nanosatlab/RFI-5G/HW/RFI-5G/RFI-5G_RF_Bottom/RFI-5G_RF_Bottom/RFI-5G_RF_Bottom_OutputJob/RFI-5G_RF_Bottom-User_1.dxf

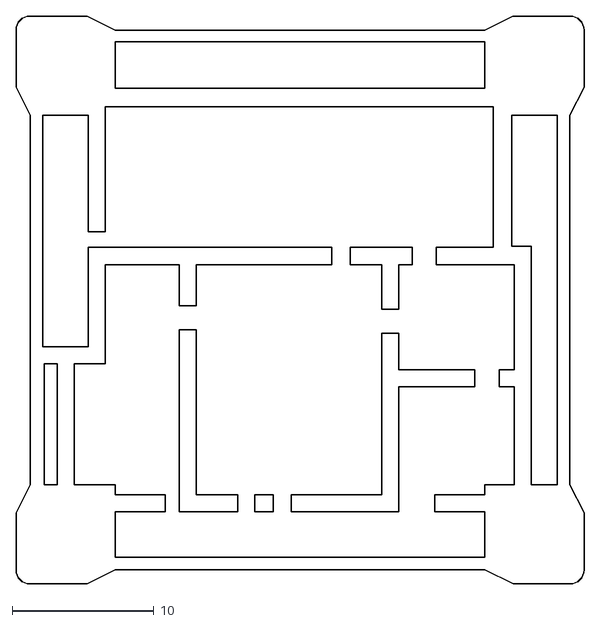
[picture p1: CAD file, 2022-07-15]
HW/RFI-5G/RFI-5G_RF_Bottom/RFI-5G_RF_Bottom/RFI-5G_RF_Bottom_OutputJob/RFI-5G_RF_Bottom-User_1.dxf
40.0 x 40.0
