nanosatlab/RFI-5G/HW/RFI-5G/RFI-5G_RF_Top/RFI-5G_RF_Top_OutputJob/RFI-5G_RF_Top-Edge_Cuts.dxf

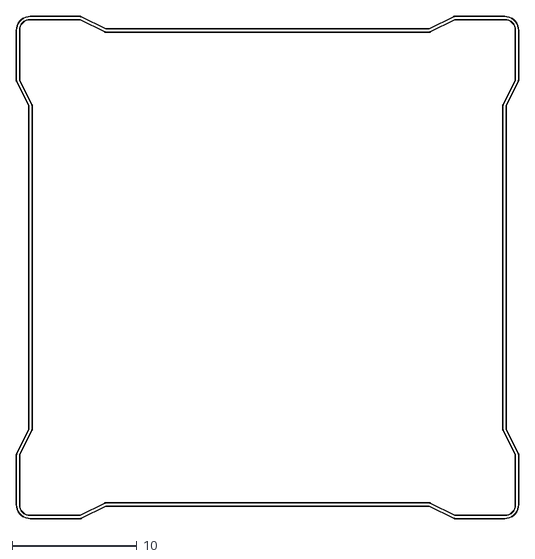
[picture p2: CAD file, 2022-07-15]
HW/RFI-5G/RFI-5G_RF_Top/RFI-5G_RF_Top_OutputJob/RFI-5G_RF_Top-Edge_Cuts.dxf
40.2 x 40.2
