nanosatlab/RFI-5G/HW/RFI-5G/RFI-5G_SupportFR4/RFI-5G_SupportFR4/RFI-5G_SupportFR4.step

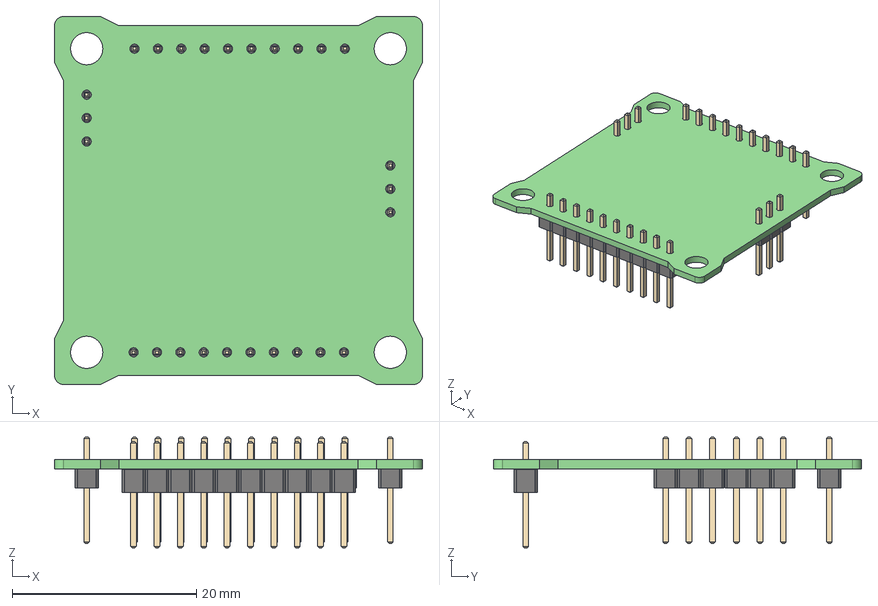
[picture p3: CAD file, 2022-08-02]
HW/RFI-5G/RFI-5G_SupportFR4/RFI-5G_SupportFR4/RFI-5G_SupportFR4.step
40.0 x 40.0 x 12.0 mm
RFI-5G_SupportFR4 PCB
