nanosatlab/RFI-5G/HW/RFI-5G/SMP-FS2A-860.stp

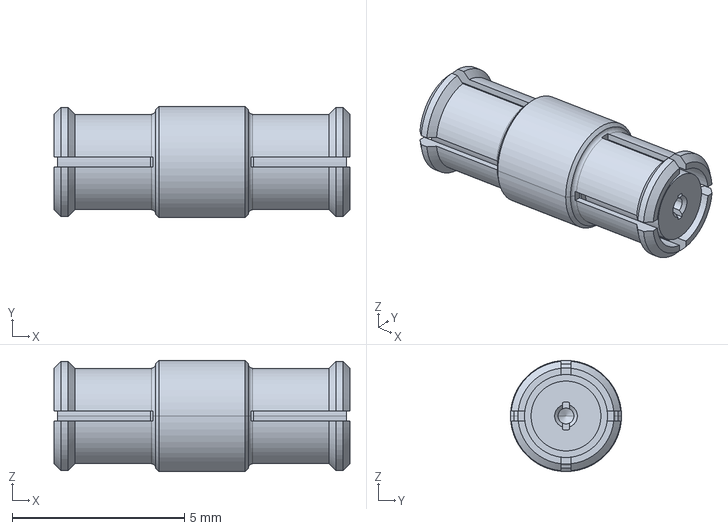
[picture p4: CAD file, 2022-07-15]
HW/RFI-5G/SMP-FS2A-860.stp
8.60 x 3.23 x 3.23 mm
