nanosatlab/RFI-5G/HW/RFI-5G/PCB_Outline_2022-03-01.step

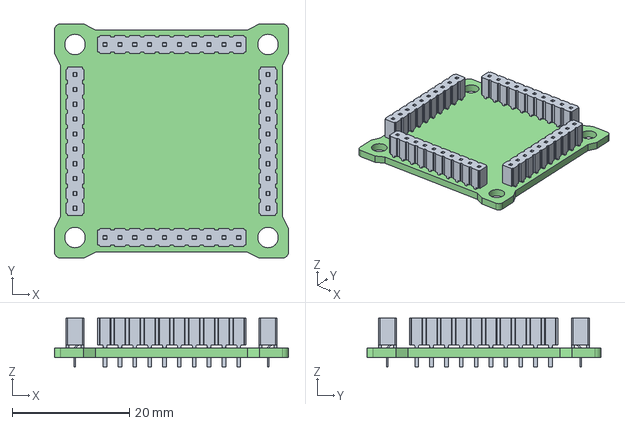
[picture p5: CAD file, 2022-07-15]
HW/RFI-5G/PCB_Outline_2022-03-01.step
40.0 x 40.0 x 8.33 mm
PCB_Outline_2022-03-01 PCB
