nanosatlab/RFI-5G/HW/RFI-5G/RFI-5G_RF_Top/RFI-5G_RF_Top_OutputJob/RFI-5G_RF_Top-User_Eco1.dxf

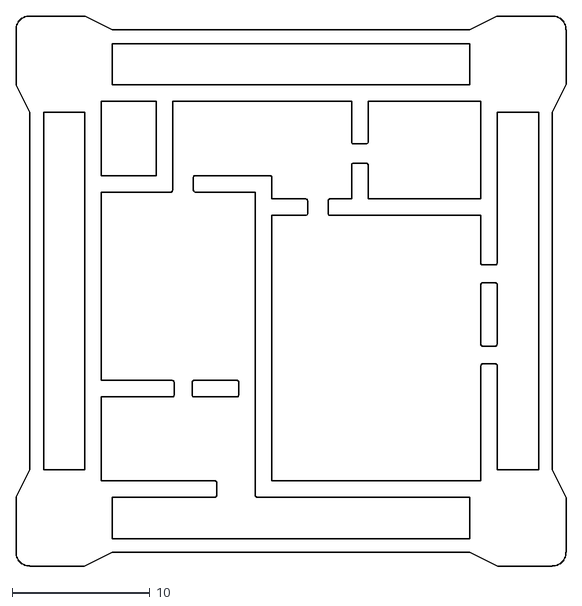
[picture p6: CAD file, 2022-07-15]
HW/RFI-5G/RFI-5G_RF_Top/RFI-5G_RF_Top_OutputJob/RFI-5G_RF_Top-User_Eco1.dxf
40.0 x 40.0
