nanosatlab/RFI-5G/HW/RFI-5G/Support_Top.STEP

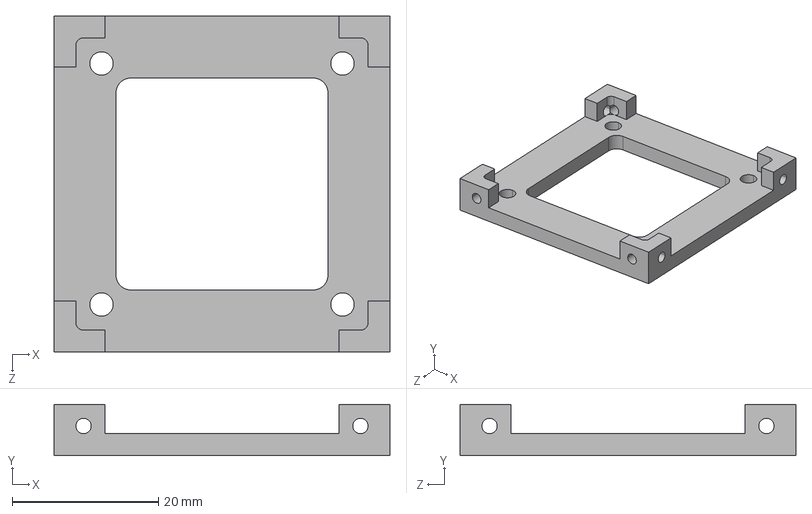
[picture p7: CAD file, 2022-06-21]
HW/RFI-5G/Support_Top.STEP
46.0 x 7.00 x 46.0 mm
