nanosatlab/RFI-5G/(list of files, cad)

Other CAD files:
HW/RFI-5G/RFI-5G_RF_Top/RFI-5G_RF_Top_OutputJob/RFI-5G_RF_Top-B_Mask.dxf
