nanosatlab/RFI-5G/HW/RFI-5G/Prova_Top&Bottom/RFI-5G_RF_Bottom&Top/RFI-5G_RF_Bottom&Top.pdf

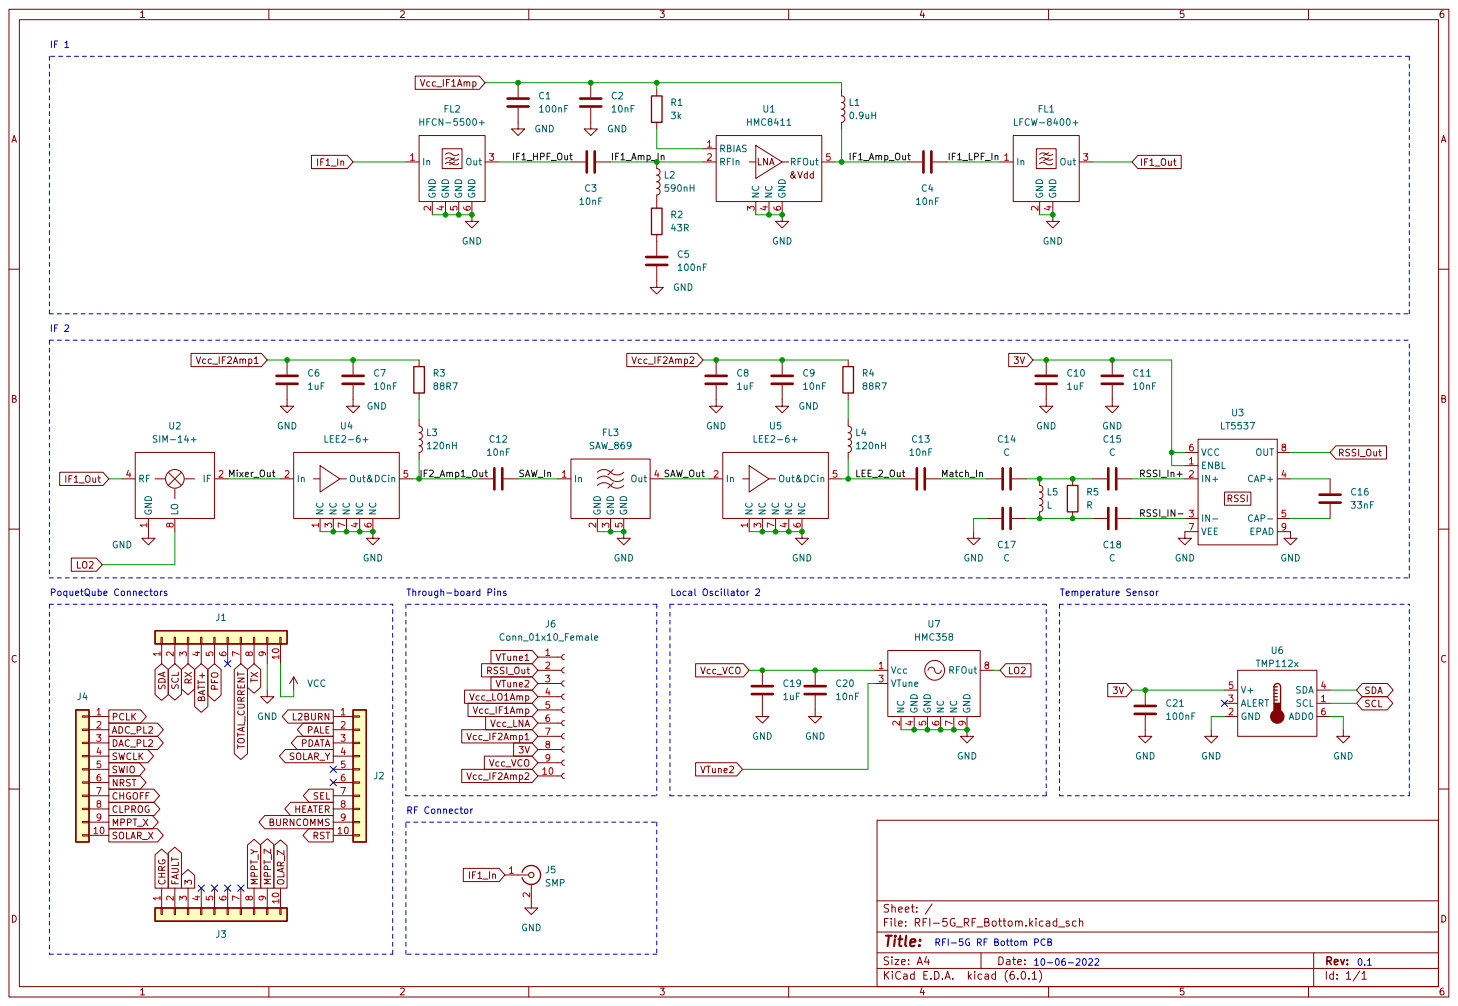
[picture p8: page 1]

10-06-2022 RFI-5G RF Bottom PCB
