nanosatlab/RFI-5G/HW/RFI-5G/RFI-5G_RF_Bottom/RFI-5G_RF_Bottom/RFI-5G_RF_Bottom.kicad_pcb

## KiCad design HW/RFI-5G/RFI-5G_RF_Bottom/RFI-5G_RF_Bottom/RFI-5G_RF_Bottom.kicad_pcb (2022-08-02)

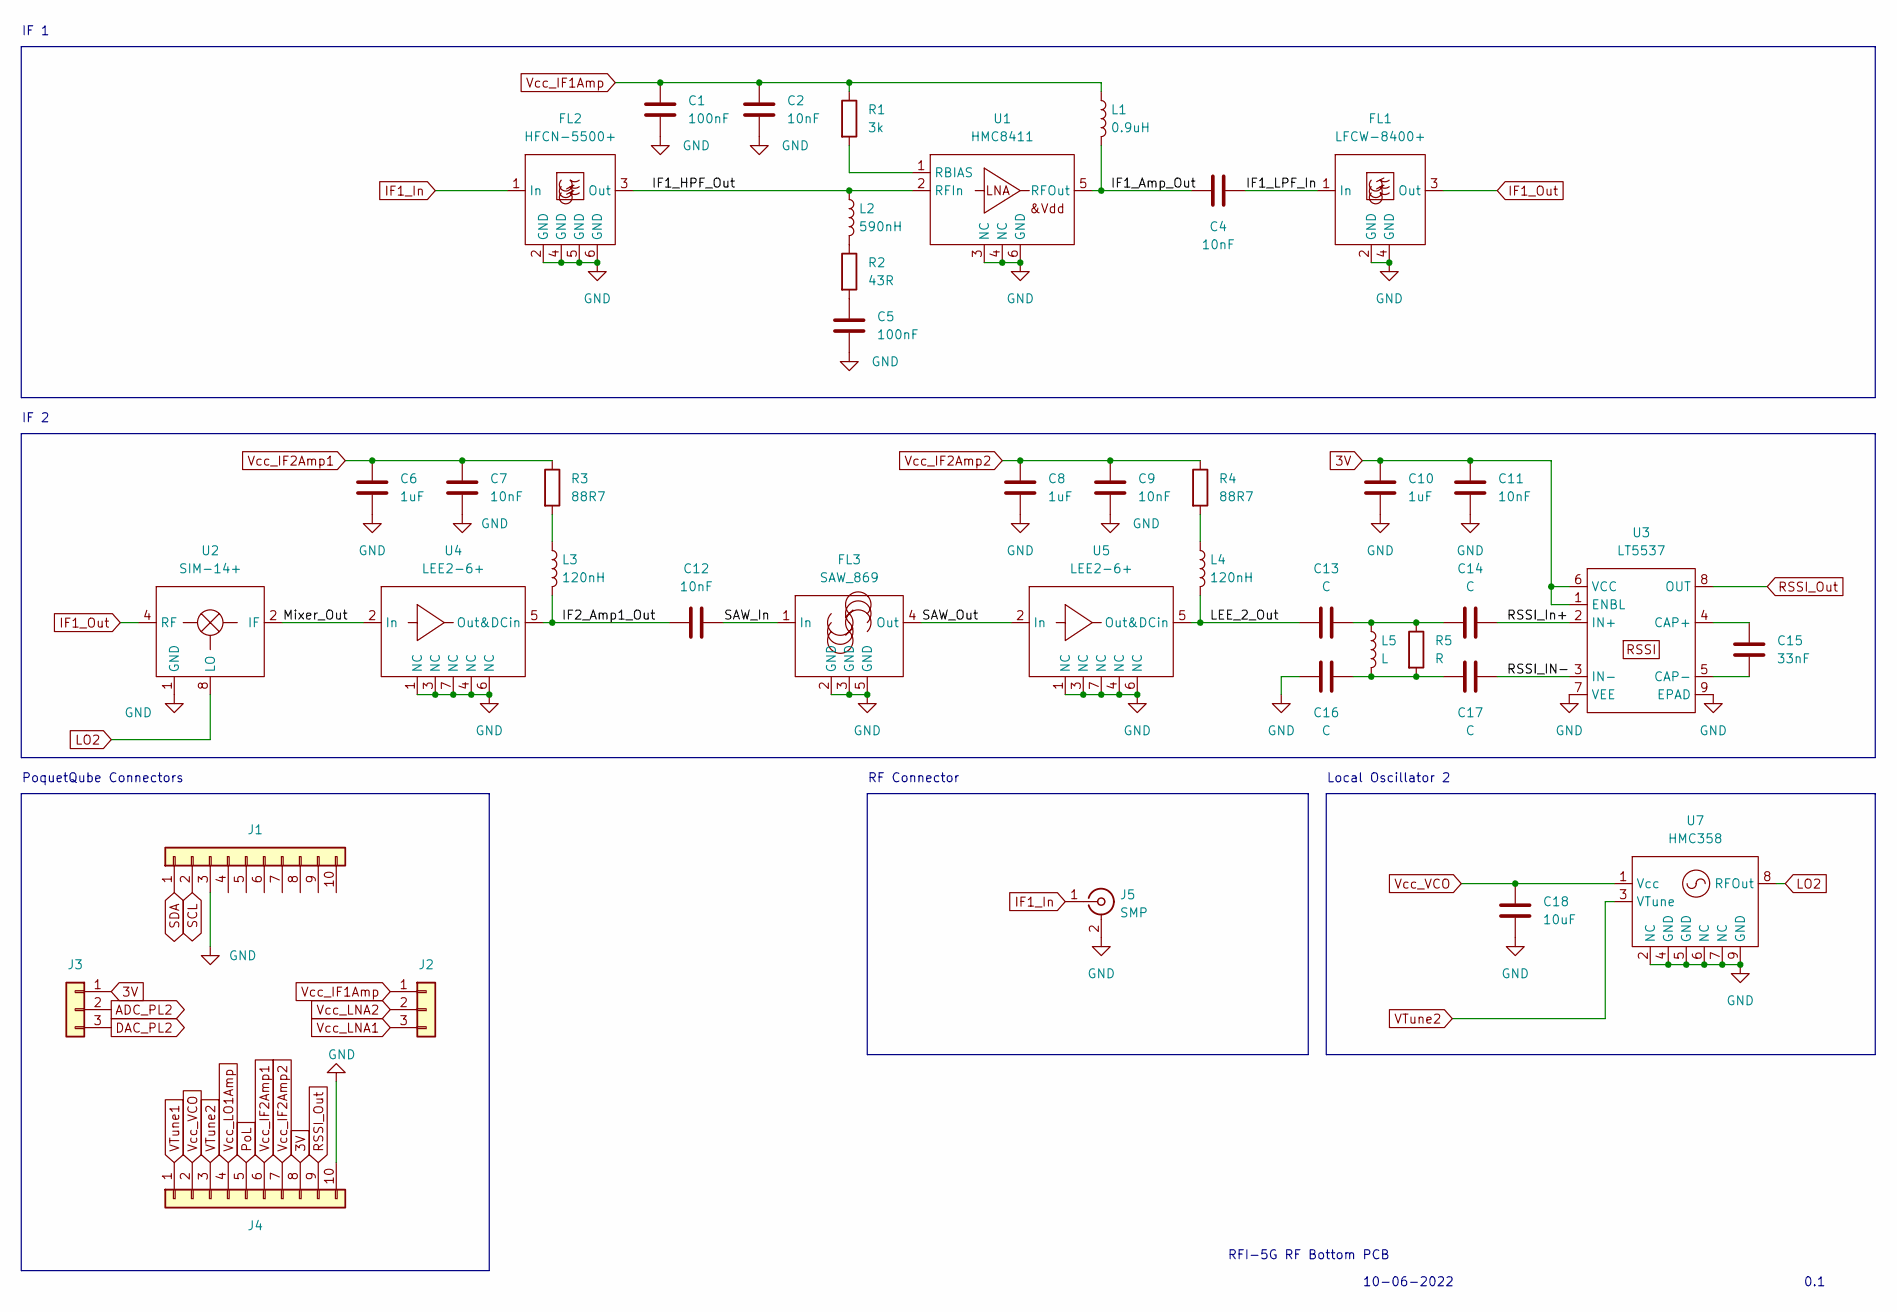
[picture p9: schematic RFI-5G_RF_Bottom.kicad_sch]

Parts:
C1, C5: 100nF; C_0402_1005Metric
C2, C4, C7, C9, C11, C12: 10nF; C_0402_1005Metric
C6, C8, C10: 1uF; C_0402_1005Metric
C13, C14, C16, C17: C; C_0402_1005Metric
C15: 33nF; C_0402_1005Metric
C18: 10uF; C_0402_1005Metric
FL1: LFCW-8400+; JC0603C-1
FL2: HFCN-5500+; JC0603C
FL3: SAW_869; QCS5P
J1, J4: Conn_01x10; PinHeader_1x10_P2.54mm_Vertical
J2, J3: Conn_01x03; PinHeader_1x03_P2.54mm_Vertical
J5: SMP; SMP_StraightPlugPCB
L1: 0.9uH; L_0603_1608Metric
L2: 590nH; L_0603_1608Metric
L3, L4: 120nH; L_0603_1608Metric
L5: L; L_0603_1608Metric
R1: 3k; R_0603_1608Metric
R2: 43R; R_0603_1608Metric
R3, R4: 88R7; R_0603_1608Metric
R5: R; R_0603_1608Metric
U1: HMC8411; 6-LFCSP
U2: SIM-14+; HV1195
U3: LT5537; DFN-8-1EP_2x3mm_P0.5mm_EP0.56x2.15mm
U4, U5: LEE2-6+; WSON-6-1EP_2x2mm_P0.65mm_EP1x1.6mm
U7: HMC358; MSOP-8-1EP_3x3mm_P0.65mm_EP2.5x3mm_Mask1.73x2.36mm

Connections:
3V: C10.2, C11.2, J3.1, J4.8, U3.1 (ENBL), U3.6 (VCC)
/IF1_Amp_Out: C4.1, L1.2, U1.5 (RFOut)
/IF1_HPF_Out: FL2.3 (Out), L2.1, U1.2 (RFIn)
/IF1_LPF_In: C4.2, FL1.1 (In)
/IF2_Amp1_Out: C12.1, L3.2, U4.5 (Out&DCin)
/LEE_2_Out: C13.1, L4.2, U5.5 (Out&DCin)
/Mixer_Out: U2.2 (IF), U4.2 (In)
/RSSI_IN-: C17.2, U3.3 (IN-)
/RSSI_In+: C14.2, U3.2 (IN+)
/SAW_In: C12.2, FL3.1 (In)
/SAW_Out: FL3.4 (Out), U5.2 (In)
ADC_PL2: J3.2
DAC_PL2: J3.3
GND: C1.1, C2.1, C5.1, C6.1, C7.1, C8.1, C9.1, C10.1, C11.1, C16.1, C18.1, FL1.2 (GND), FL1.4 (GND), FL2.2 (GND), FL2.4 (GND), FL2.5 (GND), FL2.6 (GND), FL3.2 (GND), FL3.3 (GND), FL3.5 (GND), J1.3, J4.10, J5.2 (Ext), U1.3 (NC), U1.4 (NC), U1.6 (GND), U2.1 (GND), U3.7 (VEE), U3.9 (EPAD), U4.1 (NC), U4.3 (NC), U4.4 (NC), U4.6 (NC), U4.7 (NC), U5.1 (NC), U5.3 (NC), U5.4 (NC), U5.6 (NC), U5.7 (NC), U7.2 (NC), U7.4 (GND), U7.5 (GND), U7.6 (NC), U7.7 (NC), U7.9 (GND)
IF1_In: FL2.1 (In), J5.1 (In)
IF1_Out: FL1.3 (Out), U2.4 (RF)
LO2: U2.8 (LO), U7.8 (RFOut)
unnamed: C5.2, R2.2
unnamed: C13.2, C14.1, L5.1, R5.1
unnamed: C15.1, U3.4 (CAP+)
unnamed: C15.2, U3.5 (CAP-)
unnamed: C16.2, C17.1, L5.2, R5.2
unnamed: L2.2, R2.1
unnamed: L3.1, R3.2
unnamed: L4.1, R4.2
unnamed: R1.2, U1.1 (RBIAS)
PoL: J4.5
RSSI_Out: J4.9, U3.8 (OUT)
SCL: J1.2
SDA: J1.1
VTune1: J4.1
VTune2: J4.3, U7.3 (VTune)
Vcc_IF1Amp: C1.2, C2.2, J2.1, L1.1, R1.1
Vcc_IF2Amp1: C6.2, C7.2, J4.6, R3.1
Vcc_IF2Amp2: C8.2, C9.2, J4.7, R4.1
Vcc_LNA1: J2.3
Vcc_LNA2: J2.2
Vcc_LO1Amp: J4.4
Vcc_VCO: C18.2, J4.2, U7.1 (Vcc)

Notes on the sheet:
Local Oscillator 2
0.1
IF 2
IF 1
RFI-5G RF Bottom PCB
RF Connector
10-06-2022
PoquetQube Connectors

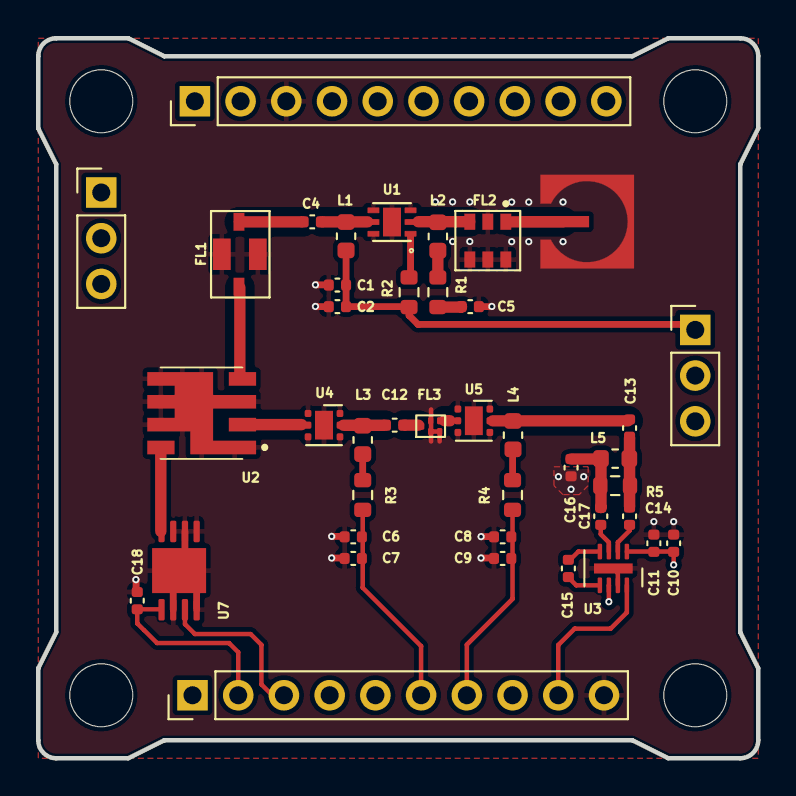
[picture p10: board RFI-5G_RF_Bottom.kicad_pcb from above]

Board: 2 copper layers, 40.0 x 40.0 mm, 41 parts (0 on the bottom side), 30 nets.
