nanosatlab/RFI-5G/HW/RFI-5G/RFI-5G_RF_Top/RFI-5G_RF_Top.kicad_pcb

## KiCad design HW/RFI-5G/RFI-5G_RF_Top/RFI-5G_RF_Top.kicad_pcb (2022-08-02)

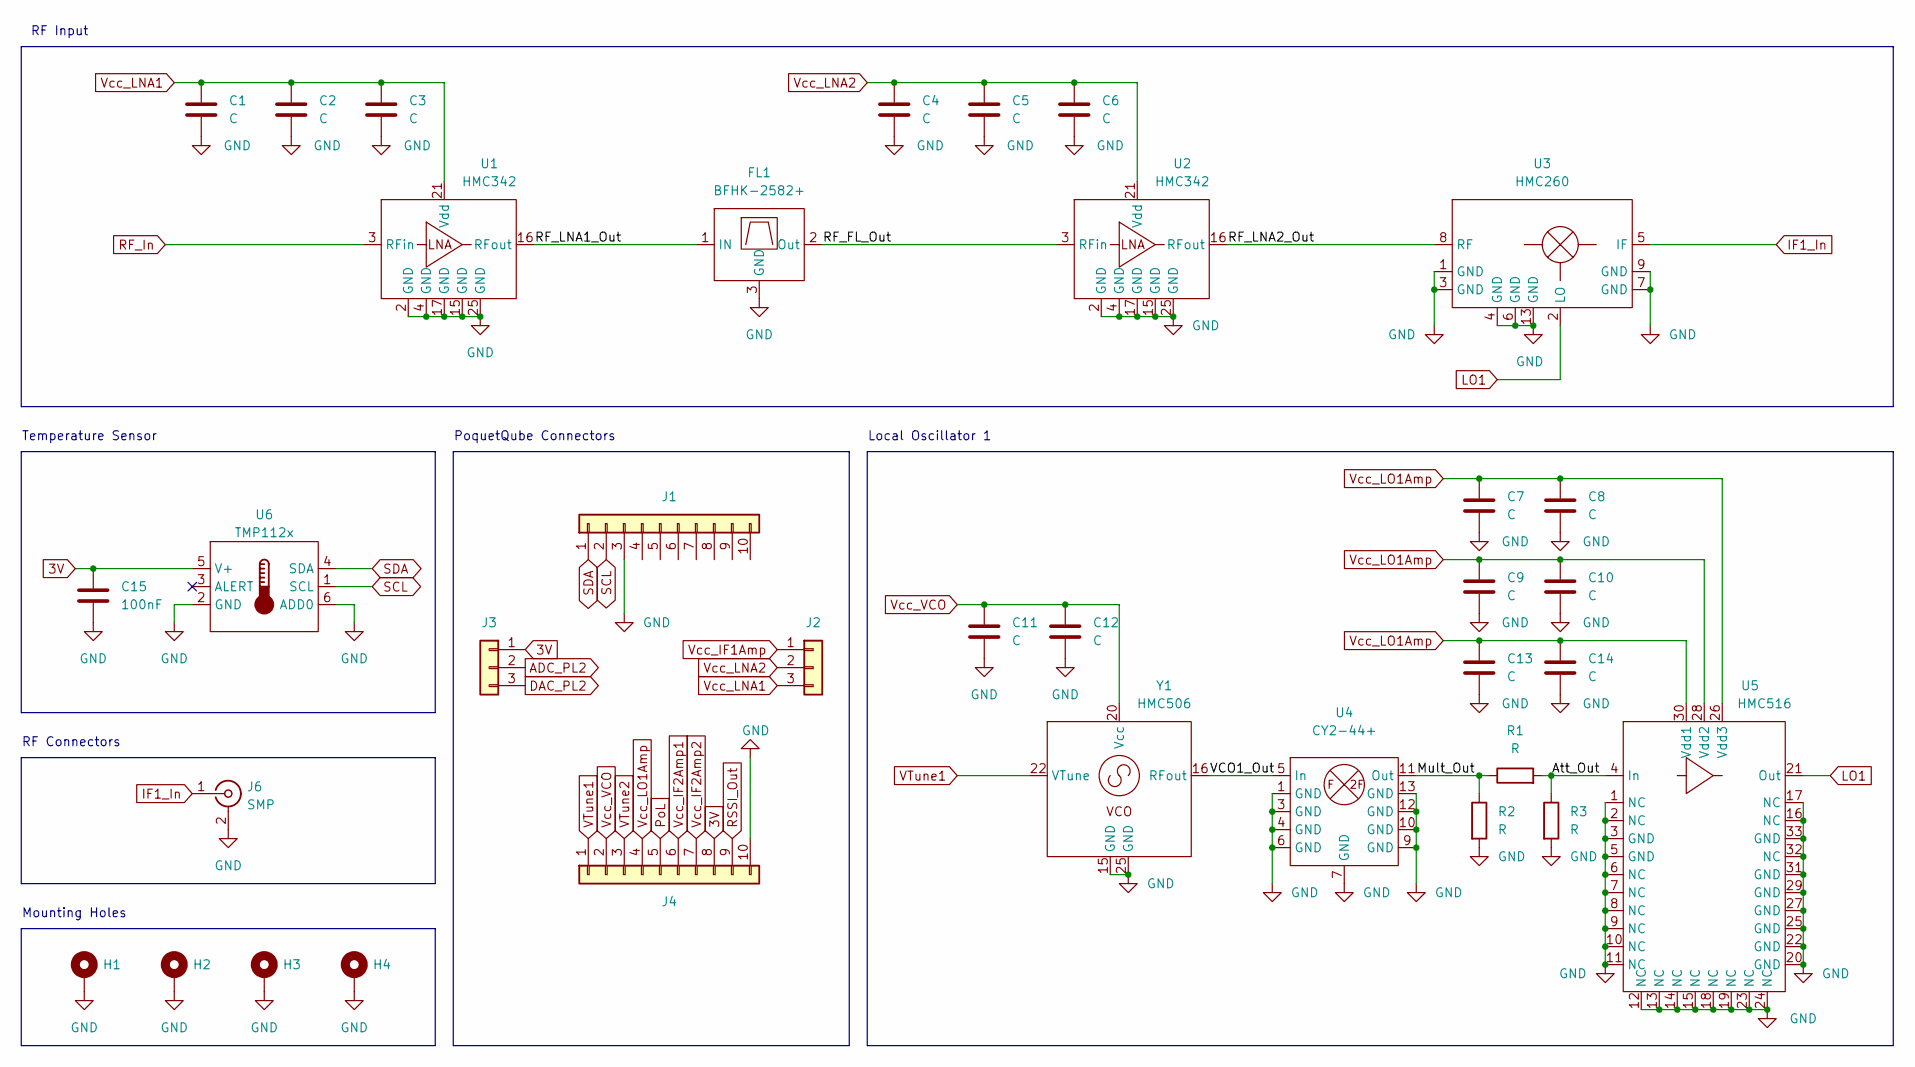
[picture p11: schematic RFI-5G_RF_Top.kicad_sch]

Parts:
C1, C2, C3, C4, C5, C6, C7, C8, C9, C10, C11, C12, C13, C14: C; C_0402_1005Metric
C15: 100nF; C_0402_1005Metric
FL1: BFHK-2582+; NM1812C-2
H1, H2, H3, H4: MountingHole_Pad
J1, J4: Conn_01x10; PinHeader_1x10_P2.54mm_Vertical
J2, J3: Conn_01x03; PinHeader_1x03_P2.54mm_Vertical
J6: SMP; SMP_StraightPlugPCB
R1, R2, R3: R; R_0402_1005Metric
U1, U2: HMC342; QFN-24-1EP_4x4mm_P0.5mm_EP2.6x2.6mm
U3: HMC260; QFN-12-1EP_3x3mm_P0.5mm_EP1.6x1.6mm
U4: CY2-44+; QFN-12-1EP_3x3mm_P0.5mm_EP1.65x1.65mm
U5: HMC516; QFN-32-1EP_5x5mm_P0.5mm_EP3.6x3.6mm
U6: TMP112x; SOT-563
Y1: HMC506; QFN-24-1EP_4x4mm_P0.5mm_EP2.7x2.7mm

Connections:
3V: C15.2, J3.1, J4.8, U6.5 (V+)
/Att_Out: R1.2, R3.1, U5.4 (In)
/Mult_Out: R1.1, R2.1, U4.11 (Out)
/RF_FL_Out: FL1.2 (Out), U2.3 (RFin)
/RF_LNA1_Out: FL1.1 (IN), U1.16 (RFout)
/RF_LNA2_Out: U2.16 (RFout), U3.8 (RF)
/VCO1_Out: U4.5 (In), Y1.16 (RFout)
ADC_PL2: J3.2
DAC_PL2: J3.3
GND: C1.2, C2.2, C3.2, C4.2, C5.2, C6.2, C7.2, C8.2, C9.2, C10.2, C11.2, C12.2, C13.2, C14.2, C15.1, FL1.3 (GND), H1.1, H2.1, H3.1, H4.1, J1.3, J4.10, J6.2 (Ext), R2.2, R3.2, U1.2 (GND), U1.4 (GND), U1.15 (GND), U1.17 (GND), U1.25 (GND), U2.2 (GND), U2.4 (GND), U2.15 (GND), U2.17 (GND), U2.25 (GND), U3.1 (GND), U3.3 (GND), U3.4 (GND), U3.6 (GND), U3.7 (GND), U3.9 (GND), U3.13 (GND), U4.1 (GND), U4.3 (GND), U4.4 (GND), U4.6 (GND), U4.7 (GND), U4.9 (GND), U4.10 (GND), U4.12 (GND), U4.13 (GND), U5.1 (NC), U5.2 (NC), U5.3 (GND), U5.5 (GND), U5.6 (NC), U5.7 (NC), U5.8 (NC), U5.9 (NC), U5.10 (NC), U5.11 (NC), U5.12 (NC), U5.13 (NC), U5.14 (NC), U5.15 (NC), U5.16 (NC), U5.17 (NC), U5.18 (NC), U5.19 (NC), U5.20 (GND), U5.22 (GND), U5.23 (NC), U5.24 (NC), U5.25 (GND), U5.27 (GND), U5.29 (GND), U5.31 (GND), U5.32 (NC), U5.33 (GND), U6.2 (GND), U6.6 (ADD0), Y1.15 (GND), Y1.25 (GND)
IF1_In: J6.1 (In), U3.5 (IF)
LO1: U3.2 (LO), U5.21 (Out)
PoL: J4.5
RF_In: U1.3 (RFin)
RSSI_Out: J4.9
SCL: J1.2, U6.1 (SCL)
SDA: J1.1, U6.4 (SDA)
VTune1: J4.1, Y1.22 (VTune)
VTune2: J4.3
Vcc_IF1Amp: J2.1
Vcc_IF2Amp1: J4.6
Vcc_IF2Amp2: J4.7
Vcc_LNA1: C1.1, C2.1, C3.1, J2.3, U1.21 (Vdd)
Vcc_LNA2: C4.1, C5.1, C6.1, J2.2, U2.21 (Vdd)
Vcc_LO1Amp: C7.1, C8.1, C9.1, C10.1, C13.1, C14.1, J4.4, U5.26 (Vdd3), U5.28 (Vdd2), U5.30 (Vdd1)
Vcc_VCO: C11.1, C12.1, J4.2, Y1.20 (Vcc)

Notes on the sheet:
Mounting Holes
PoquetQube Connectors
RF Input
Temperature Sensor
RF Connectors
Local Oscillator 1

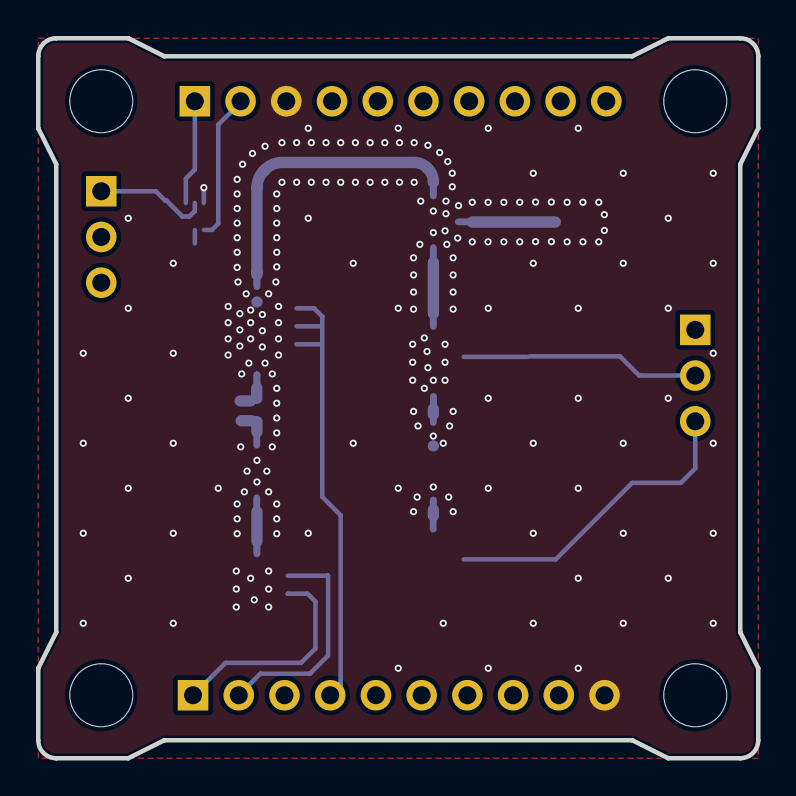
[picture p12: board RFI-5G_RF_Top.kicad_pcb from above]

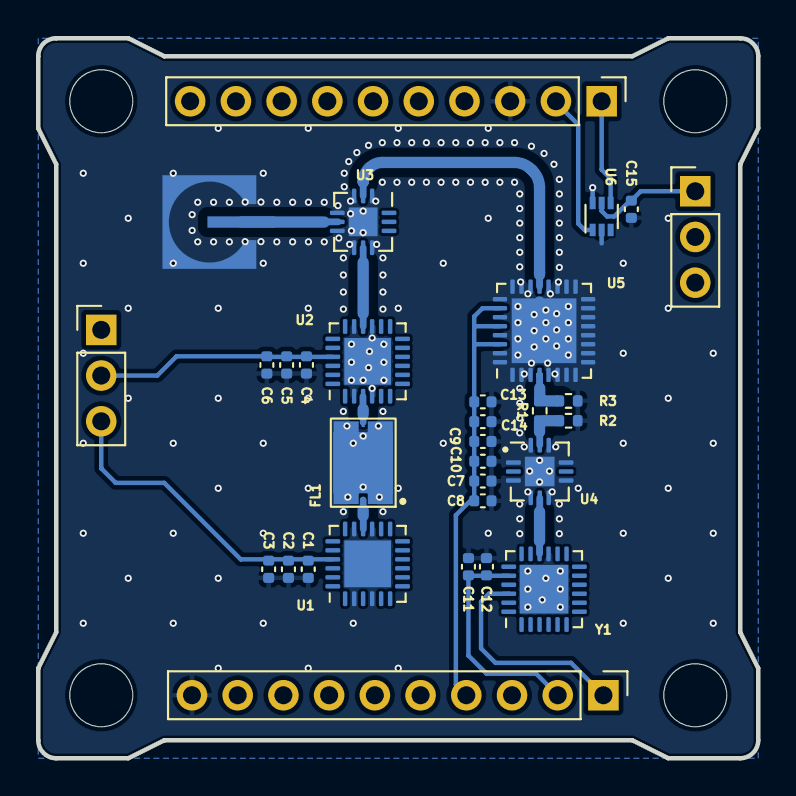
[picture p13: board RFI-5G_RF_Top.kicad_pcb from below]

Board: 2 copper layers, 40.0 x 40.0 mm, 35 parts (31 on the bottom side), 17 nets.
