nanosatlab/RFI-5G/HW/RFI-5G/RFI-5G_Interface/low_freq_board.kicad_pcb

## KiCad design HW/RFI-5G/RFI-5G_Interface/low_freq_board.kicad_pcb (2022-06-24)

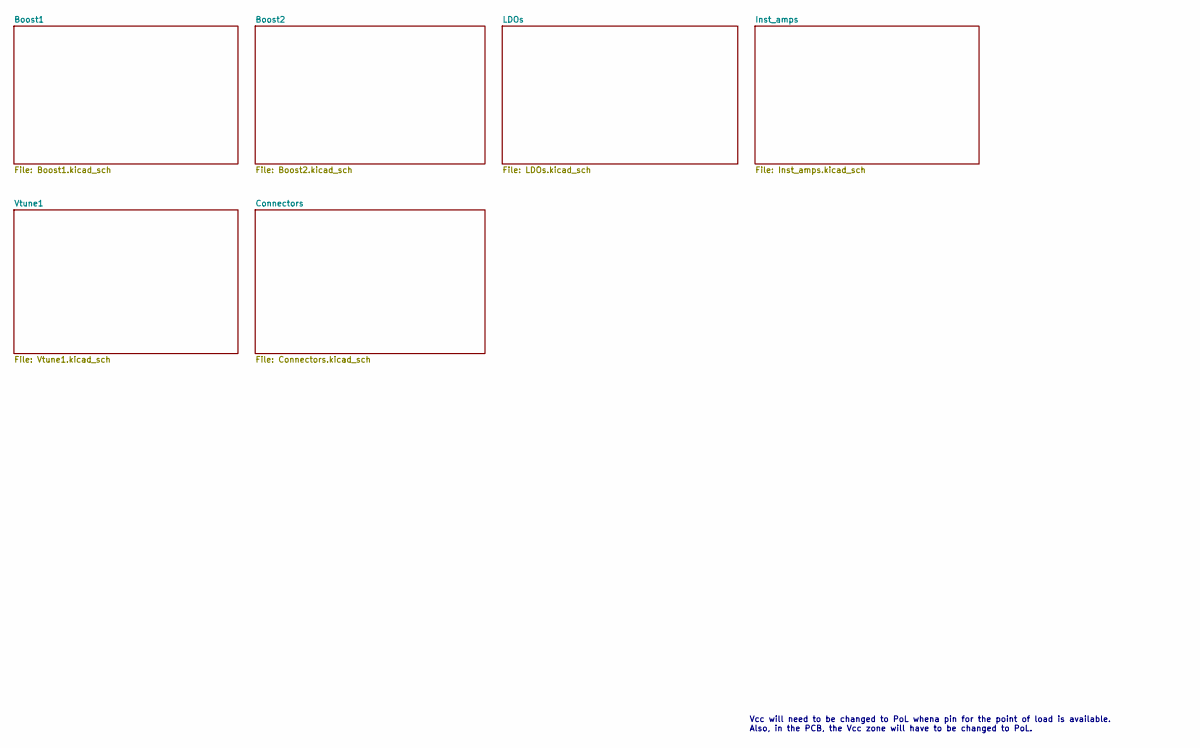
[picture p14: schematic low_freq_board.kicad_sch]

Notes on the sheet:
Vcc will need to be changed to PoL whena pin for the point of load is available. Also, in the PCB, the Vcc zone will have to be changed to PoL.

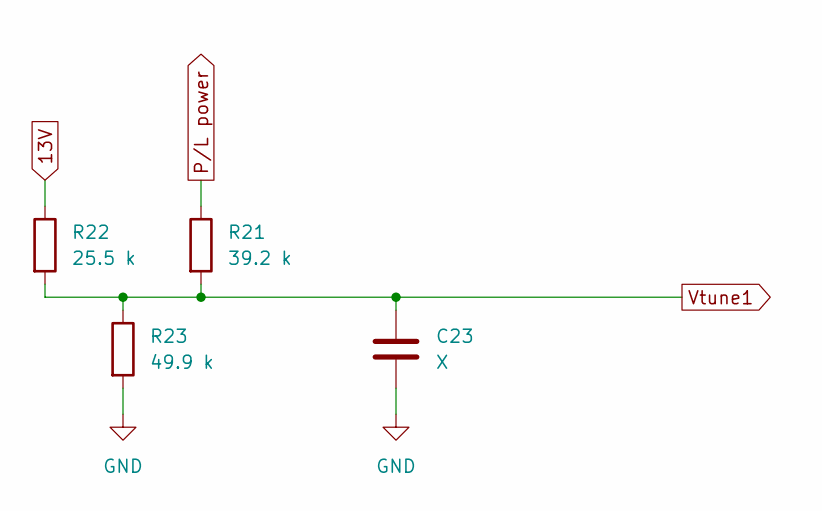
[picture p15: schematic Vtune1.kicad_sch]

Parts:
C23: X; C_0603_1608Metric_Pad1.08x0.95mm_HandSolder
R21: 39.2 k; R_0603_1608Metric_Pad0.98x0.95mm_HandSolder
R22: 25.5 k; R_0402_1005Metric_Pad0.72x0.64mm_HandSolder
R23: 49.9 k; R_0402_1005Metric_Pad0.72x0.64mm_HandSolder

Connections:
13V: R22.1; also elsewhere on the board
GND: C23.2, R23.2; also elsewhere on the board
P/L power: R21.1; also elsewhere on the board
Vtune1: C23.1, R21.2, R22.2, R23.1

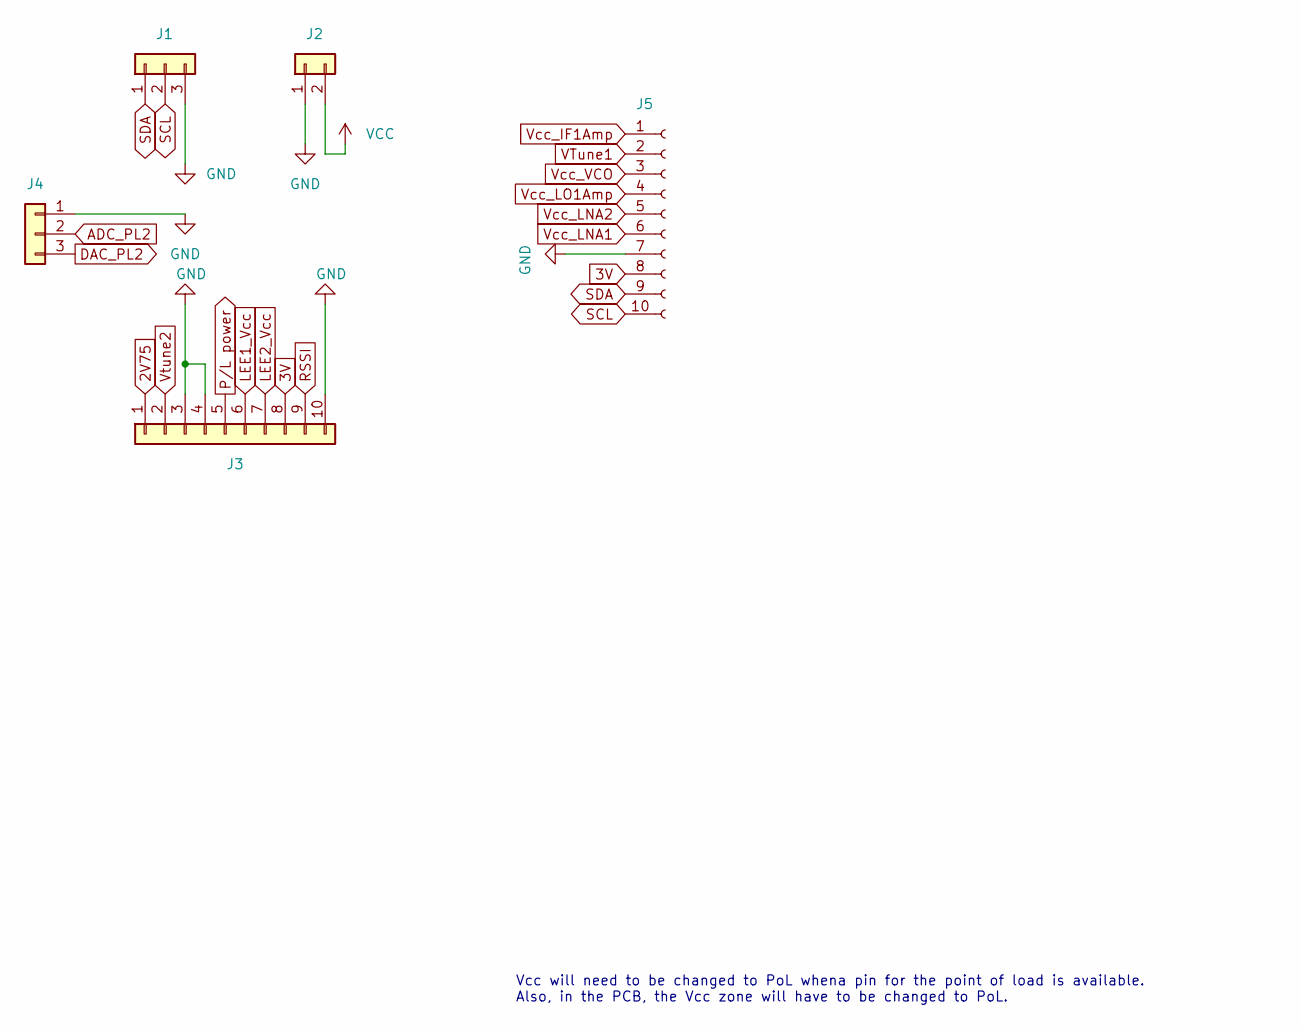
[picture p16: schematic Connectors.kicad_sch]

Parts:
J1, J4: Conn_01x03; PinHeader_1x03_P2.54mm_Vertical
J2: Conn_01x02; PinHeader_1x02_P2.54mm_Vertical
J3: Conn_01x10; PinHeader_1x10_P2.54mm_Vertical
J5: Conn_01x10_Female; PinHeader_1x10_P1.00mm_Vertical

Connections:
2V75: J3.1; also elsewhere on the board
3V: J3.8, J5.8; also elsewhere on the board
ADC_PL2: J4.2; also elsewhere on the board
DAC_PL2: J4.3; also elsewhere on the board
GND: J1.3, J2.1, J3.3, J3.4, J3.10, J4.1, J5.7; also elsewhere on the board
LEE1_Vcc: J3.6; also elsewhere on the board
LEE2_Vcc: J3.7; also elsewhere on the board
P/L power: J3.5; also elsewhere on the board
RSSI: J3.9; also elsewhere on the board
SCL: J1.2, J5.10
SDA: J1.1, J5.9
VCC: J2.2
VTune1: J5.2
Vcc_IF1Amp: J5.1
Vcc_LNA1: J5.6
Vcc_LNA2: J5.5
Vcc_LO1Amp: J5.4
Vcc_VCO: J5.3
Vtune2: J3.2; also elsewhere on the board

Notes on the sheet:
Vcc will need to be changed to PoL whena pin for the point of load is available. Also, in the PCB, the Vcc zone will have to be changed to PoL.

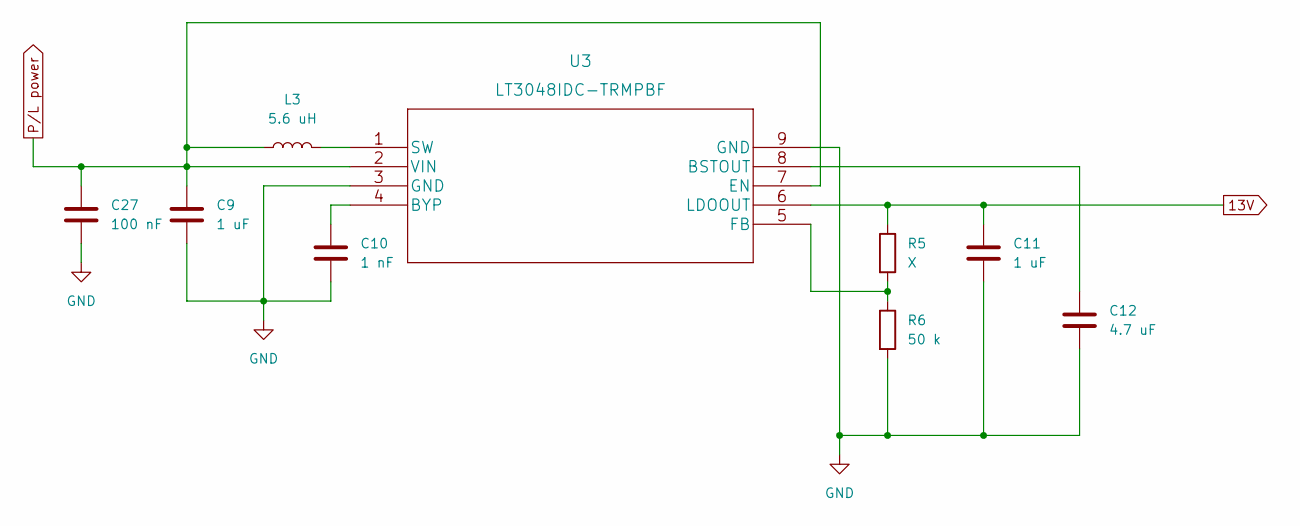
[picture p17: schematic Boost2.kicad_sch]

Parts:
C9, C11: 1 uF; C_0603_1608Metric_Pad1.08x0.95mm_HandSolder
C10: 1 nF; C_0603_1608Metric_Pad1.08x0.95mm_HandSolder
C12: 4.7 uF; C_0603_1608Metric_Pad1.08x0.95mm_HandSolder
C27: 100 nF; C_0603_1608Metric_Pad1.08x0.95mm_HandSolder
L3: 5.6 uH; ASPI-4030S-100M-T
R5: X; R_0603_1608Metric_Pad0.98x0.95mm_HandSolder
R6: 50 k; R_0603_1608Metric_Pad0.98x0.95mm_HandSolder
U3: LT3048IDC-TRMPBF

Connections:
13V: C11.1, R5.1, U3.6 (LDOOUT); also elsewhere on the board
GND: C9.2, C10.2, C11.2, C12.2, C27.2, R6.2, U3.3 (GND), U3.9 (GND); also elsewhere on the board
unnamed: C10.1, U3.4 (BYP)
unnamed: C12.1, U3.8 (BSTOUT)
unnamed: L3.2, U3.1 (SW)
unnamed: R5.2, R6.1, U3.5 (FB)
P/L power: C9.1, C27.1, L3.1, U3.2 (VIN), U3.7 (EN); also elsewhere on the board

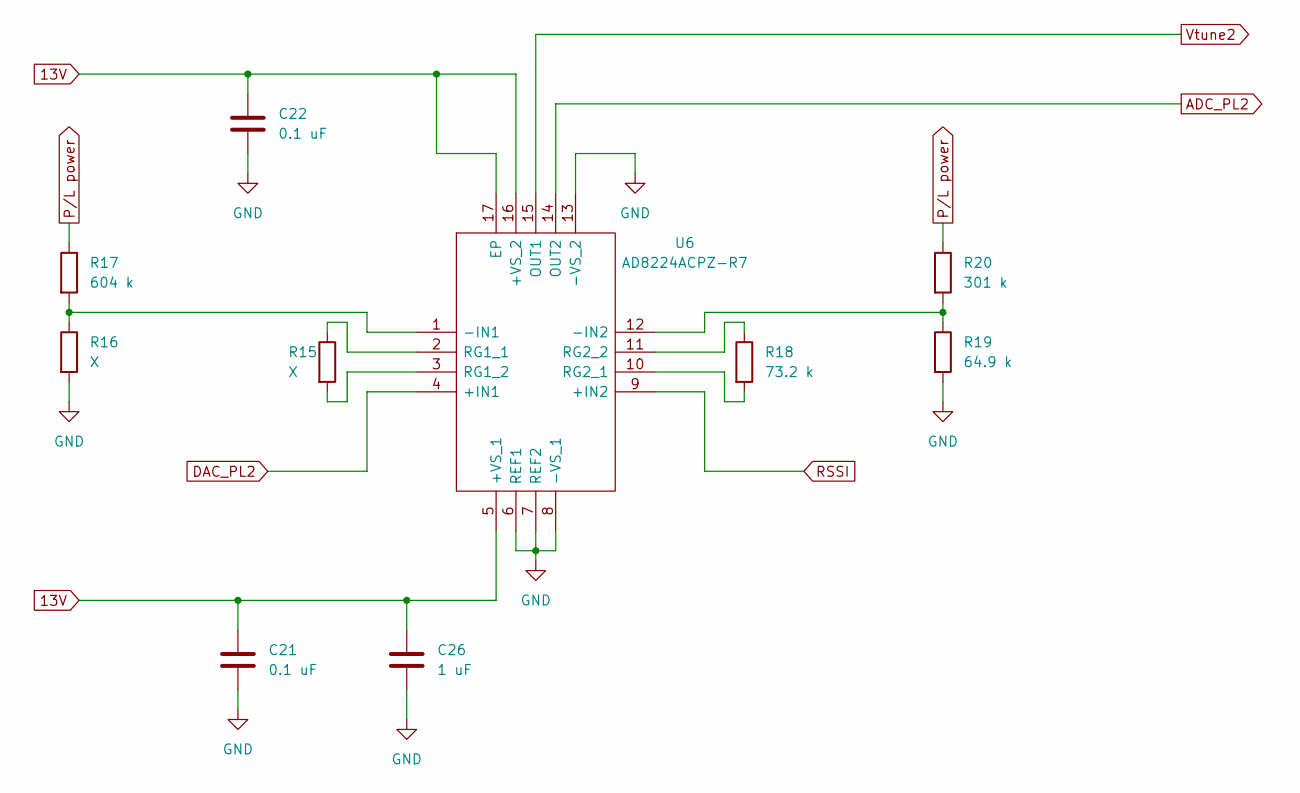
[picture p18: schematic Inst_amps.kicad_sch]

Parts:
C21, C22: 0.1 uF; C_0402_1005Metric_Pad0.74x0.62mm_HandSolder
C26: 1 uF; C_0603_1608Metric_Pad1.08x0.95mm_HandSolder
R15, R16: X; R_0603_1608Metric_Pad0.98x0.95mm_HandSolder
R17: 604 k; R_0603_1608Metric_Pad0.98x0.95mm_HandSolder
R18: 73.2 k; R_0603_1608Metric_Pad0.98x0.95mm_HandSolder
R19: 64.9 k; R_0603_1608Metric_Pad0.98x0.95mm_HandSolder
R20: 301 k; R_0603_1608Metric_Pad0.98x0.95mm_HandSolder
U6: AD8224ACPZ-R7; QFN65P400X400X90-17N; Mouser Part Number 584-AD8224ACPZ-R7

Connections:
13V: C21.1, C22.1, C26.1, U6.5 (+VS_1), U6.16 (+VS_2), U6.17 (EP); also elsewhere on the board
ADC_PL2: U6.14 (OUT2); also elsewhere on the board
DAC_PL2: U6.4 (+IN1); also elsewhere on the board
GND: C21.2, C22.2, C26.2, R16.2, R19.2, U6.6 (REF1), U6.7 (REF2), U6.8 (-VS_1), U6.13 (-VS_2); also elsewhere on the board
unnamed: R15.1, U6.2 (RG1_1)
unnamed: R15.2, U6.3 (RG1_2)
unnamed: R16.1, R17.2, U6.1 (-IN1)
unnamed: R18.1, U6.11 (RG2_2)
unnamed: R18.2, U6.10 (RG2_1)
unnamed: R19.1, R20.2, U6.12 (-IN2)
P/L power: R17.1, R20.1; also elsewhere on the board
RSSI: U6.9 (+IN2); also elsewhere on the board
Vtune2: U6.15 (OUT1); also elsewhere on the board

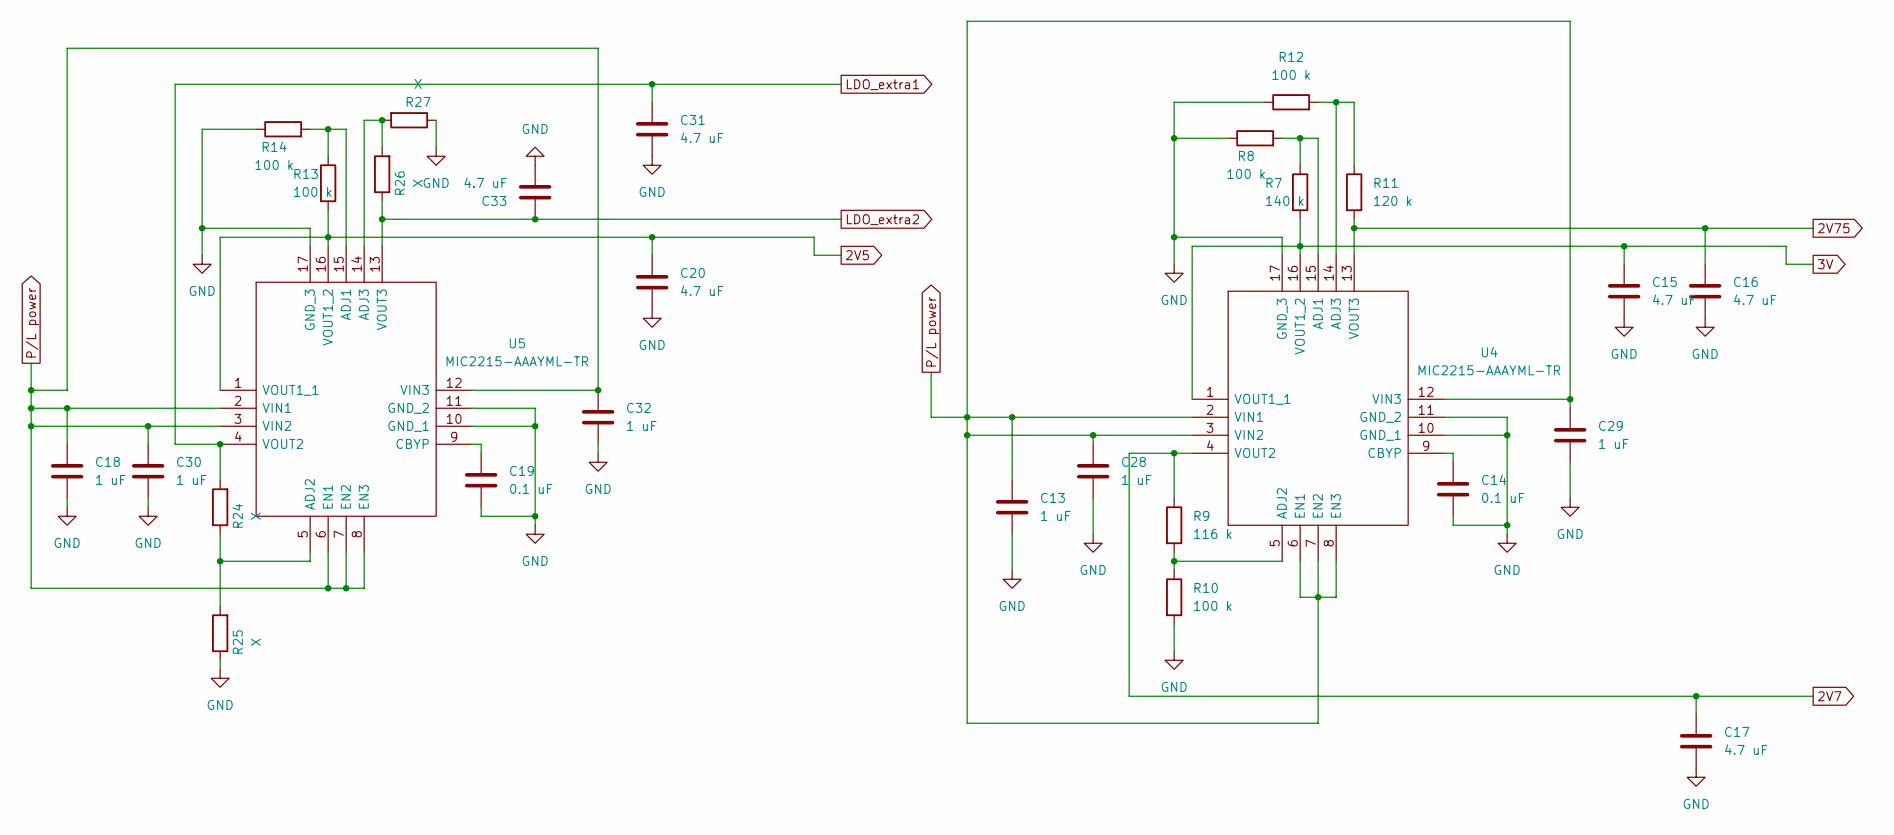
[picture p19: schematic LDOs.kicad_sch]

Parts:
C13, C18, C28, C29, C30, C32: 1 uF; C_0603_1608Metric_Pad1.08x0.95mm_HandSolder
C14, C19: 0.1 uF; C_0402_1005Metric_Pad0.74x0.62mm_HandSolder
C15, C16, C17, C20, C31, C33: 4.7 uF; C_0603_1608Metric_Pad1.08x0.95mm_HandSolder
R7: 140 k; R_0603_1608Metric_Pad0.98x0.95mm_HandSolder
R8, R10, R12, R13, R14: 100 k; R_0603_1608Metric_Pad0.98x0.95mm_HandSolder
R9: 116 k; R_0603_1608Metric_Pad0.98x0.95mm_HandSolder
R11: 120 k; R_0603_1608Metric_Pad0.98x0.95mm_HandSolder
R24, R25, R26, R27: X; R_0603_1608Metric_Pad0.98x0.95mm_HandSolder
U4, U5: MIC2215-AAAYML-TR; QFN65P400X400X90-17N; Mouser Part Number 998-MIC2215-AAAYMLTR

Connections:
2V5: C20.1, R13.2, U5.1 (VOUT1_1), U5.16 (VOUT1_2)
2V7: C17.1, R9.1, U4.4 (VOUT2)
2V75: C16.1, R11.2, U4.13 (VOUT3); also elsewhere on the board
3V: C15.1, R7.2, U4.1 (VOUT1_1), U4.16 (VOUT1_2); also elsewhere on the board
GND: C13.2, C14.2, C15.2, C16.2, C17.2, C18.2, C19.2, C20.2, C28.2, C29.2, C30.2, C31.2, C32.2, C33.2, R8.1, R10.2, R12.1, R14.1, R25.1, R27.1, U4.10 (GND_1), U4.11 (GND_2), U4.17 (GND_3), U5.10 (GND_1), U5.11 (GND_2), U5.17 (GND_3); also elsewhere on the board
LDO_extra1: C31.1, R24.2, U5.4 (VOUT2)
LDO_extra2: C33.1, R26.1, U5.13 (VOUT3)
unnamed: C14.1, U4.9 (CBYP)
unnamed: C19.1, U5.9 (CBYP)
unnamed: R7.1, R8.2, U4.15 (ADJ1)
unnamed: R9.2, R10.1, U4.5 (ADJ2)
unnamed: R11.1, R12.2, U4.14 (ADJ3)
unnamed: R13.1, R14.2, U5.15 (ADJ1)
unnamed: R24.1, R25.2, U5.5 (ADJ2)
unnamed: R26.2, R27.2, U5.14 (ADJ3)
P/L power: C13.1, C18.1, C28.1, C29.1, C30.1, C32.1, U4.2 (VIN1), U4.3 (VIN2), U4.6 (EN1), U4.7 (EN2), U4.8 (EN3), U4.12 (VIN3), U5.2 (VIN1), U5.3 (VIN2), U5.6 (EN1), U5.7 (EN2), U5.8 (EN3), U5.12 (VIN3); also elsewhere on the board

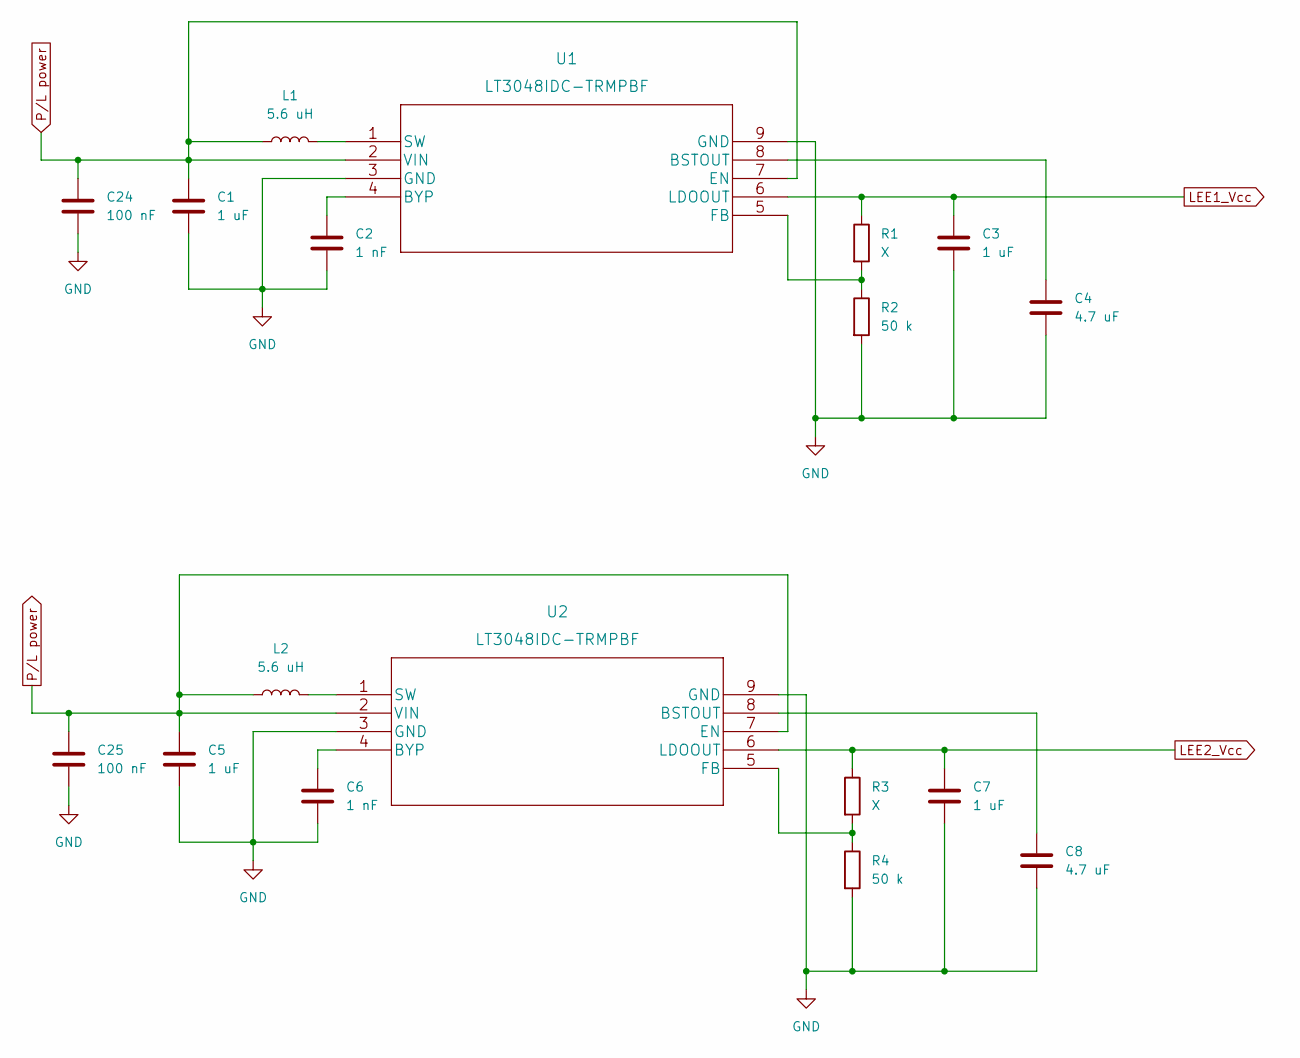
[picture p20: schematic Boost1.kicad_sch]

Parts:
C1, C3, C5, C7: 1 uF; C_0603_1608Metric_Pad1.08x0.95mm_HandSolder
C2, C6: 1 nF; C_0603_1608Metric_Pad1.08x0.95mm_HandSolder
C4, C8: 4.7 uF; C_0603_1608Metric_Pad1.08x0.95mm_HandSolder
C24, C25: 100 nF; C_0603_1608Metric_Pad1.08x0.95mm_HandSolder
L1, L2: 5.6 uH; ASPI-4030S-100M-T
R1, R3: X; R_0603_1608Metric_Pad0.98x0.95mm_HandSolder
R2, R4: 50 k; R_0603_1608Metric_Pad0.98x0.95mm_HandSolder
U1, U2: LT3048IDC-TRMPBF

Connections:
GND: C1.2, C2.2, C3.2, C4.2, C5.2, C6.2, C7.2, C8.2, C24.2, C25.2, R2.2, R4.2, U1.3 (GND), U1.9 (GND), U2.3 (GND), U2.9 (GND); also elsewhere on the board
LEE1_Vcc: C3.1, R1.1, U1.6 (LDOOUT); also elsewhere on the board
LEE2_Vcc: C7.1, R3.1, U2.6 (LDOOUT); also elsewhere on the board
unnamed: C2.1, U1.4 (BYP)
unnamed: C4.1, U1.8 (BSTOUT)
unnamed: C6.1, U2.4 (BYP)
unnamed: C8.1, U2.8 (BSTOUT)
unnamed: L1.2, U1.1 (SW)
unnamed: L2.2, U2.1 (SW)
unnamed: R1.2, R2.1, U1.5 (FB)
unnamed: R3.2, R4.1, U2.5 (FB)
P/L power: C1.1, C5.1, C24.1, C25.1, L1.1, L2.1, U1.2 (VIN), U1.7 (EN), U2.2 (VIN), U2.7 (EN); also elsewhere on the board

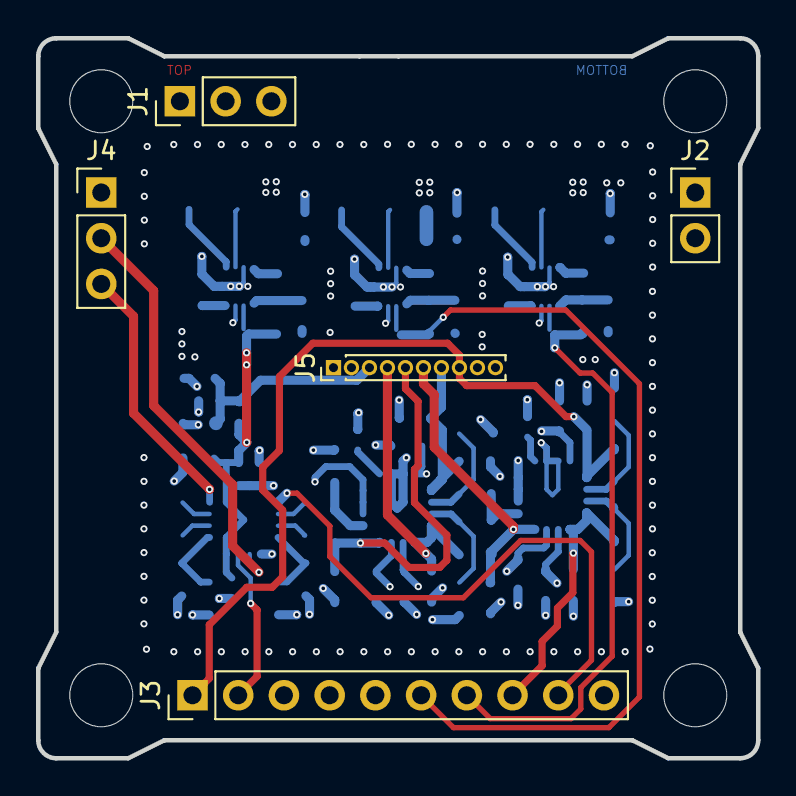
[picture p21: board low_freq_board.kicad_pcb from above]

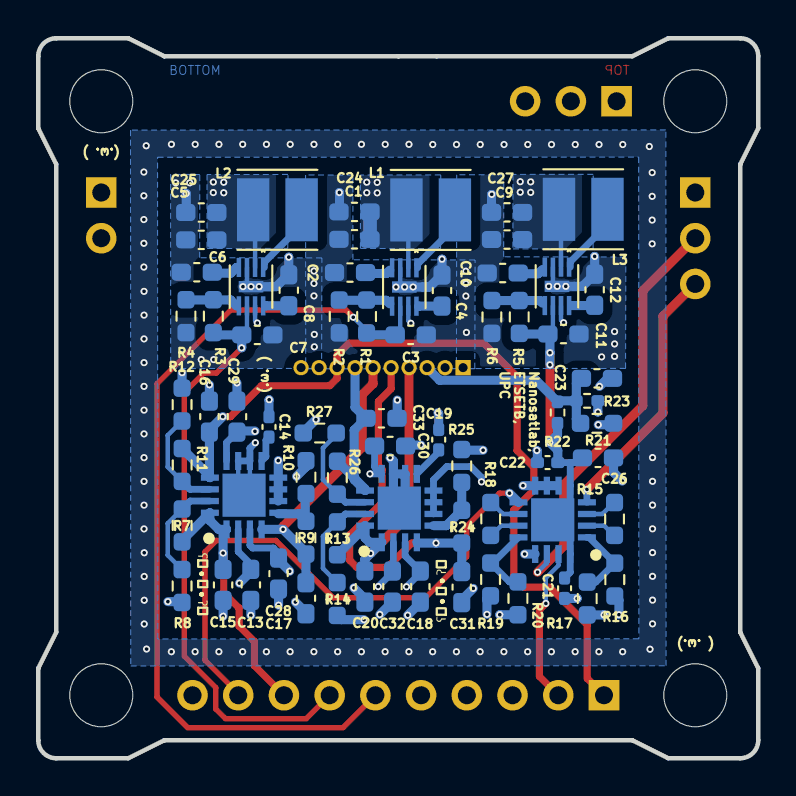
[picture p22: board low_freq_board.kicad_pcb from below]

Board: 4 copper layers, 40.0 x 40.0 mm, 74 parts (69 on the bottom side), 44 nets.
