nanosatlab/RFI-5G/HW/TestBoards/LO2_EvalBoard/VCO_2.kicad_pcb

## KiCad design HW/TestBoards/LO2_EvalBoard/VCO_2.kicad_pcb (2022-03-31)

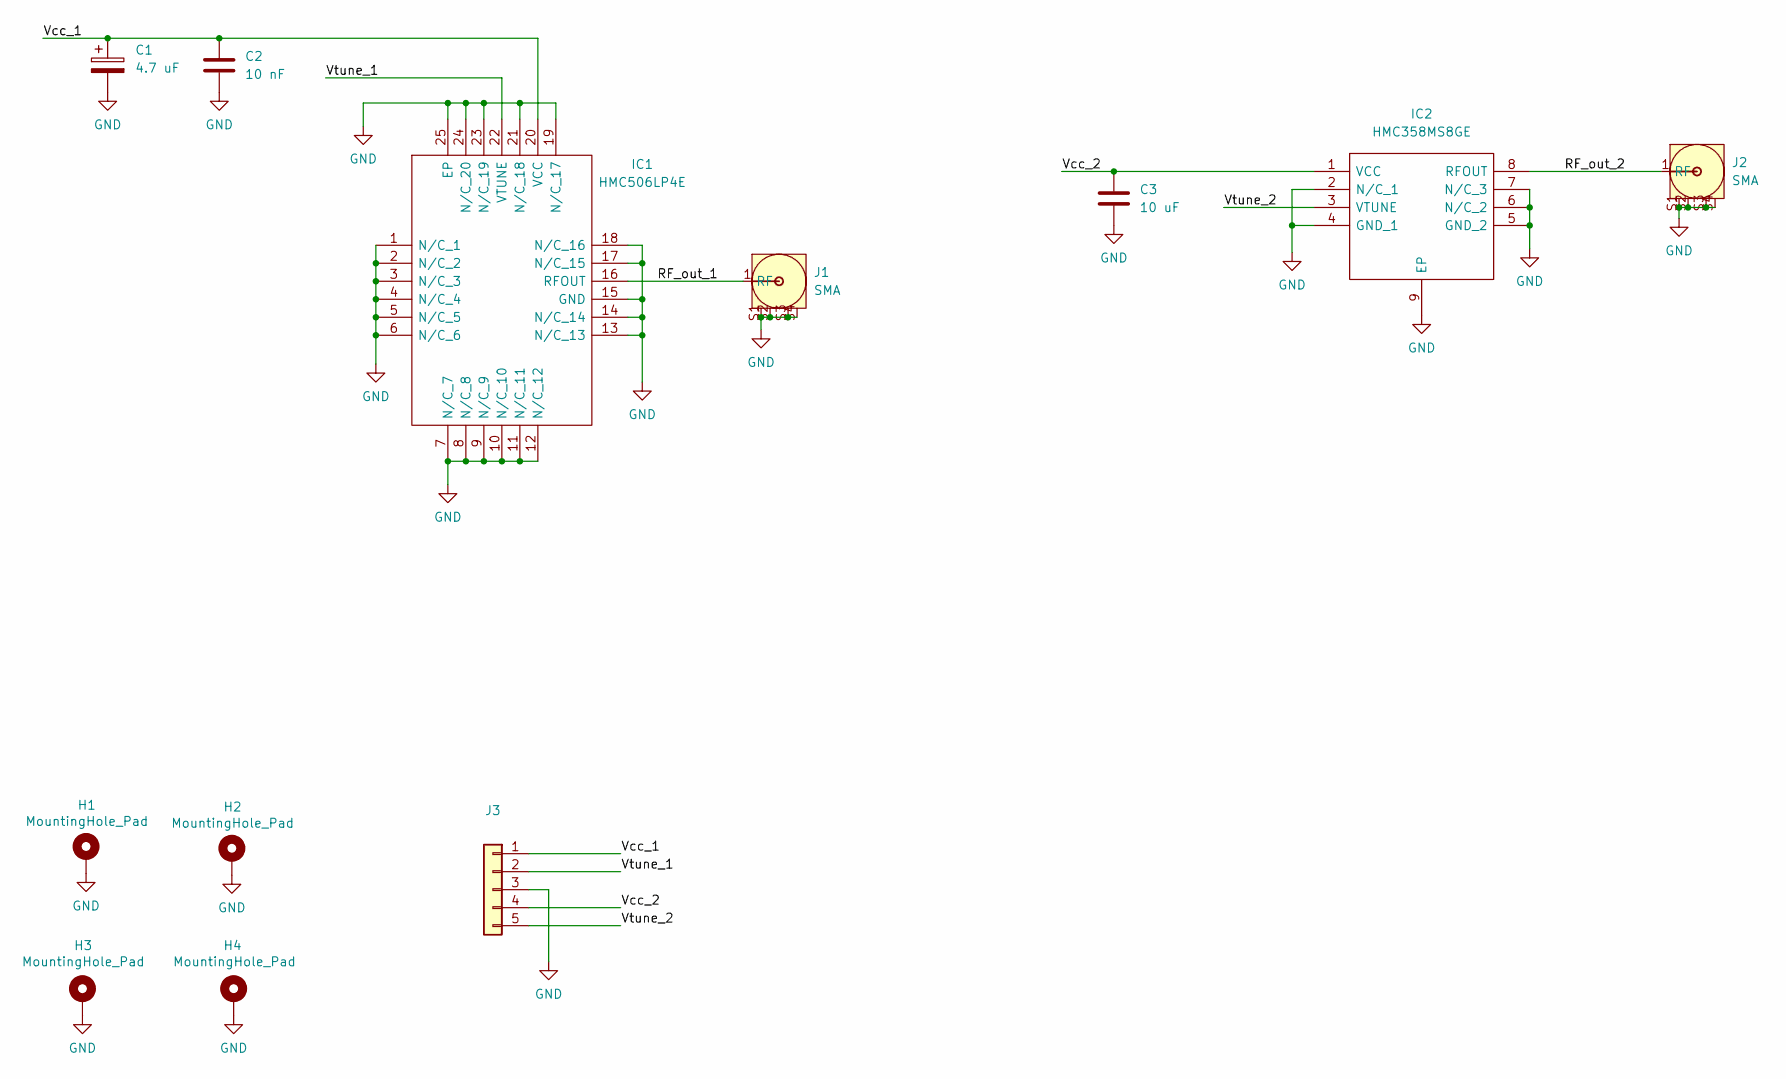
[picture p23: schematic VCO_2.kicad_sch]

Parts:
C1: 4.7 uF; C_0603_1608Metric_Pad1.08x0.95mm_HandSolder
C2: 10 nF; C_0603_1608Metric_Pad1.08x0.95mm_HandSolder
C3: 10 uF; C_0603_1608Metric_Pad1.08x0.95mm_HandSolder
H1, H2, H3, H4: MountingHole_Pad; MountingHole_2.5mm_Pad
IC1: HMC506LP4E; QFN50P400X400X100-25N; Mouser Part Number 584-HMC506LP4E
IC2: HMC358MS8GE; SOP65P488X110-9N; Mouser Part Number 584-HMC358MS8GE
J1, J2: SMA; LINX_CONSMA020.062-G
J3: (no value)

Connections:
/RF_out_1: IC1.16 (RFOUT), J1.1 (RF)
/RF_out_2: IC2.8 (RFOUT), J2.1 (RF)
/Vcc_1: C1.1, C2.1, IC1.20 (VCC), J3.1
/Vcc_2: C3.1, IC2.1 (VCC), J3.4
/Vtune_1: IC1.22 (VTUNE), J3.2
/Vtune_2: IC2.3 (VTUNE), J3.5
GND: C1.2, C2.2, C3.2, H1.1, H2.1, H3.1, H4.1, IC1.1 (N/C_1), IC1.2 (N/C_2), IC1.3 (N/C_3), IC1.4 (N/C_4), IC1.5 (N/C_5), IC1.6 (N/C_6), IC1.7 (N/C_7), IC1.8 (N/C_8), IC1.9 (N/C_9), IC1.10 (N/C_10), IC1.11 (N/C_11), IC1.12 (N/C_12), IC1.13 (N/C_13), IC1.14 (N/C_14), IC1.15 (GND), IC1.17 (N/C_15), IC1.18 (N/C_16), IC1.19 (N/C_17), IC1.21 (N/C_18), IC1.23 (N/C_19), IC1.24 (N/C_20), IC1.25 (EP), IC2.2 (N/C_1), IC2.4 (GND_1), IC2.5 (GND_2), IC2.6 (N/C_2), IC2.7 (N/C_3), IC2.9 (EP), J1.S1, J1.S2, J1.S3, J1.S4, J2.S1, J2.S2, J2.S3, J2.S4, J3.3

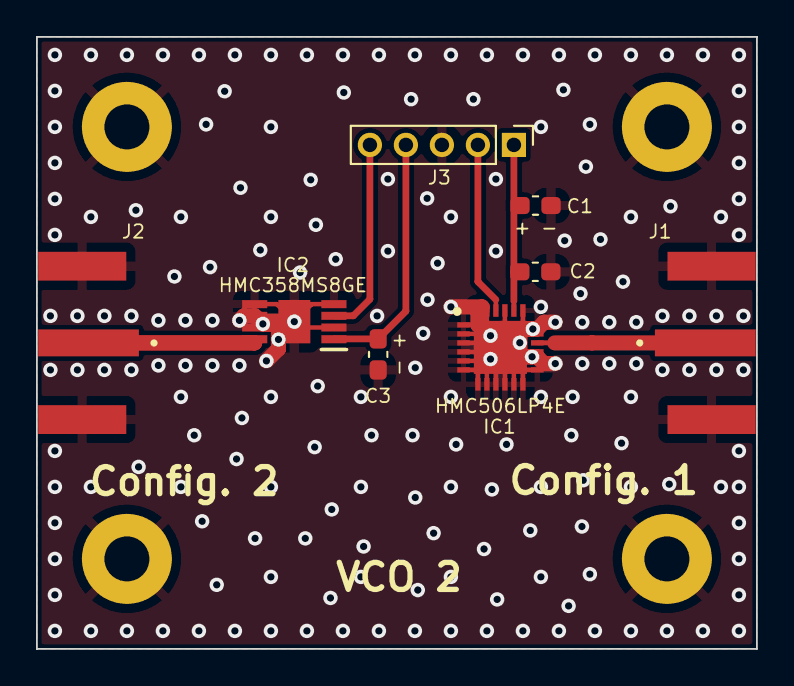
[picture p24: board VCO_2.kicad_pcb from above]

Board: 2 copper layers, 40.0 x 34.0 mm, 12 parts (0 on the bottom side), 7 nets.
