nanosatlab/RFI-5G/HW/TestBoards/LNAs_EvalBoard/LNAs_EvalBoard.kicad_pcb

## KiCad design HW/TestBoards/LNAs_EvalBoard/LNAs_EvalBoard.kicad_pcb (2022-04-07)

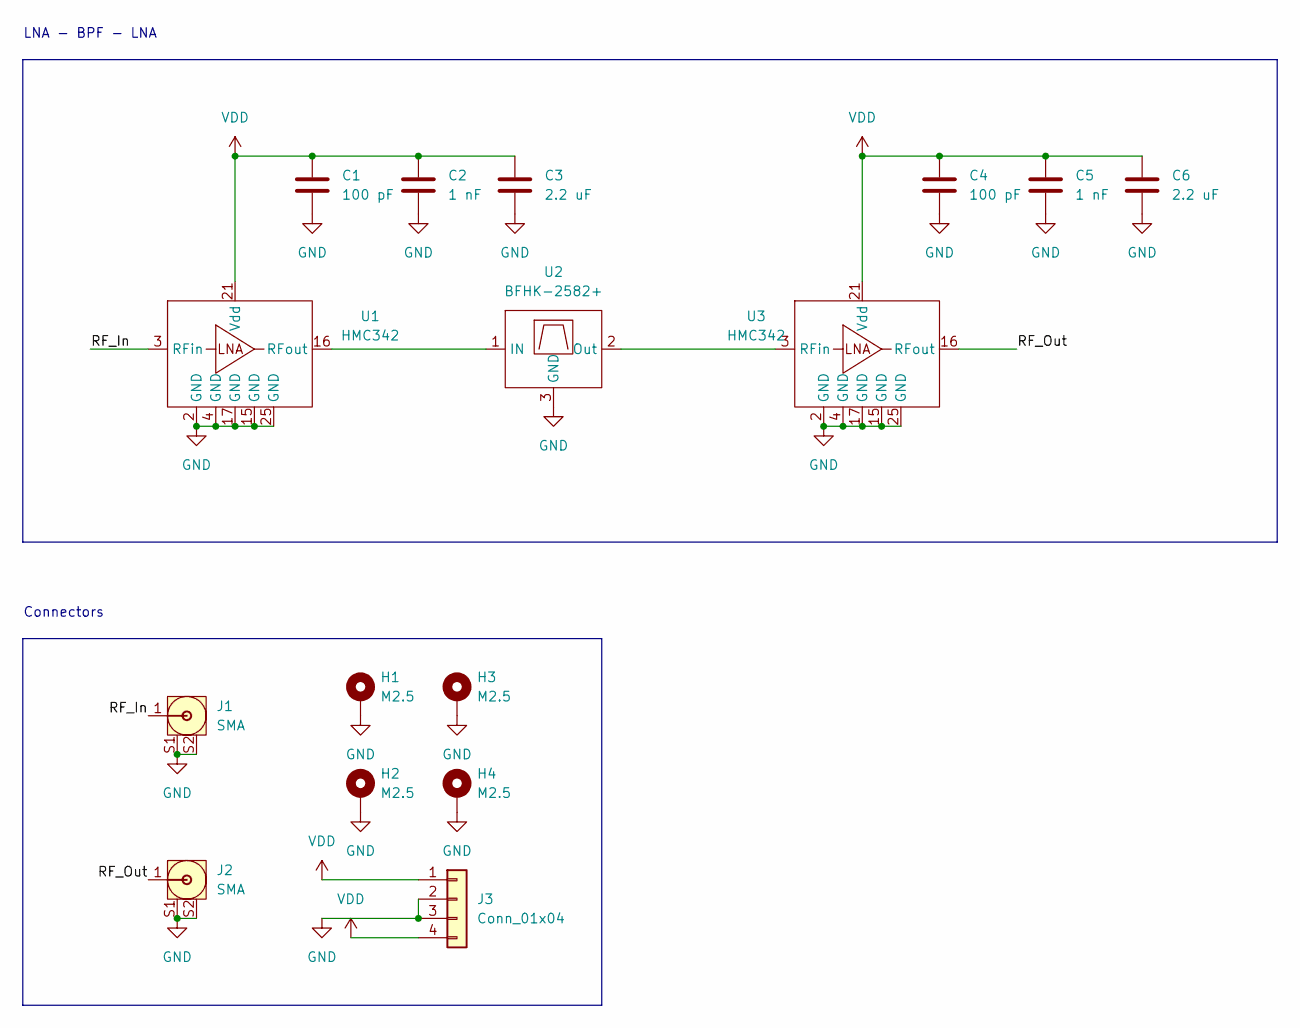
[picture p25: schematic LNAs_EvalBoard.kicad_sch]

Parts:
C1, C4: 100 pF; C_0603_1608Metric
C2, C5: 1 nF; C_0603_1608Metric
C3, C6: 2.2 uF; C_0603_1608Metric
H1, H2, H3, H4: M2.5; MountingHole_2.7mm_M2.5_Pad
J1, J2: SMA; Johnson_142-0761-861
J3: Conn_01x04; PinSocket_1x04_P2.00mm_Vertical
U1, U3: HMC342; QFN-24-1EP_4x4mm_P0.5mm_EP2.6x2.6mm
U2: BFHK-2582+; NM1812C-2

Connections:
/RF_In: J1.1, U1.3 (RFin)
/RF_Out: J2.1, U3.16 (RFout)
GND: C1.2, C2.2, C3.2, C4.2, C5.2, C6.2, H1.1, H2.1, H3.1, H4.1, J1.S1, J1.S2, J2.S1, J2.S2, J3.2, J3.3, U1.2 (GND), U1.4 (GND), U1.15 (GND), U1.17 (GND), U1.25 (GND), U2.3 (GND), U3.2 (GND), U3.4 (GND), U3.15 (GND), U3.17 (GND), U3.25 (GND)
unnamed: U1.16 (RFout), U2.1 (IN)
unnamed: U2.2 (Out), U3.3 (RFin)
VDD: C1.1, C2.1, C3.1, C4.1, C5.1, C6.1, J3.1, J3.4, U1.21 (Vdd), U3.21 (Vdd)

Notes on the sheet:
Connectors
LNA - BPF - LNA

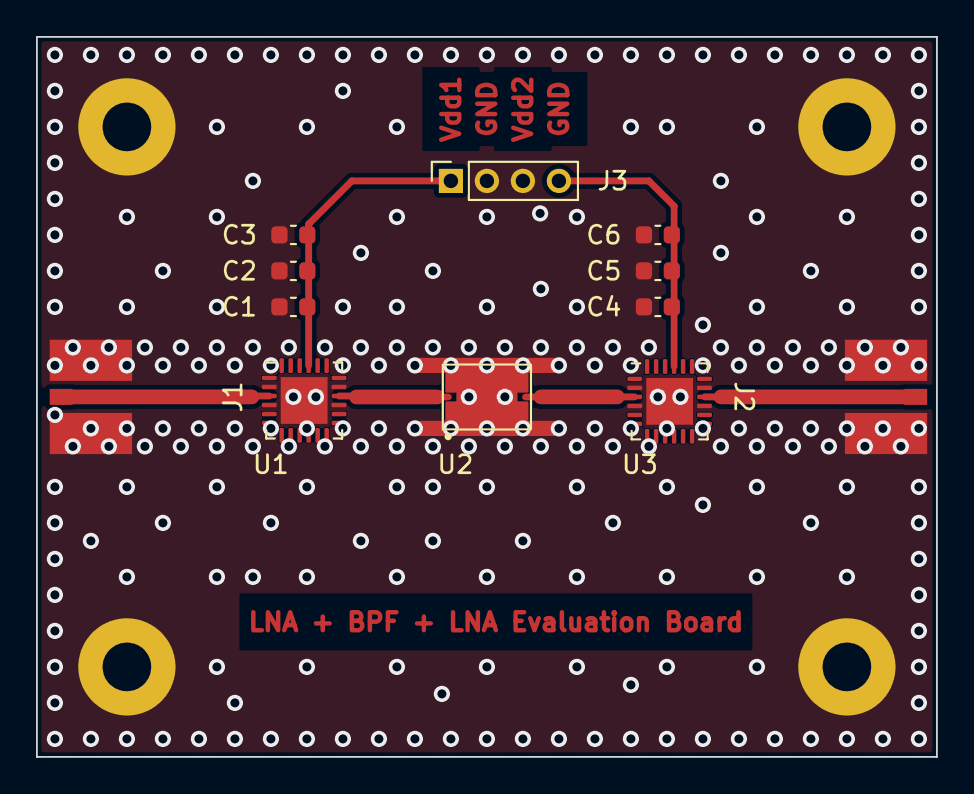
[picture p26: board LNAs_EvalBoard.kicad_pcb from above]

Board: 2 copper layers, 50.0 x 40.0 mm, 16 parts (0 on the bottom side), 6 nets.
