nanosatlab/RFI-5G/HW/TestBoards/IF2_EvalBoard/Mixer_2.kicad_pcb

## KiCad design HW/TestBoards/IF2_EvalBoard/Mixer_2.kicad_pcb (2022-03-31)

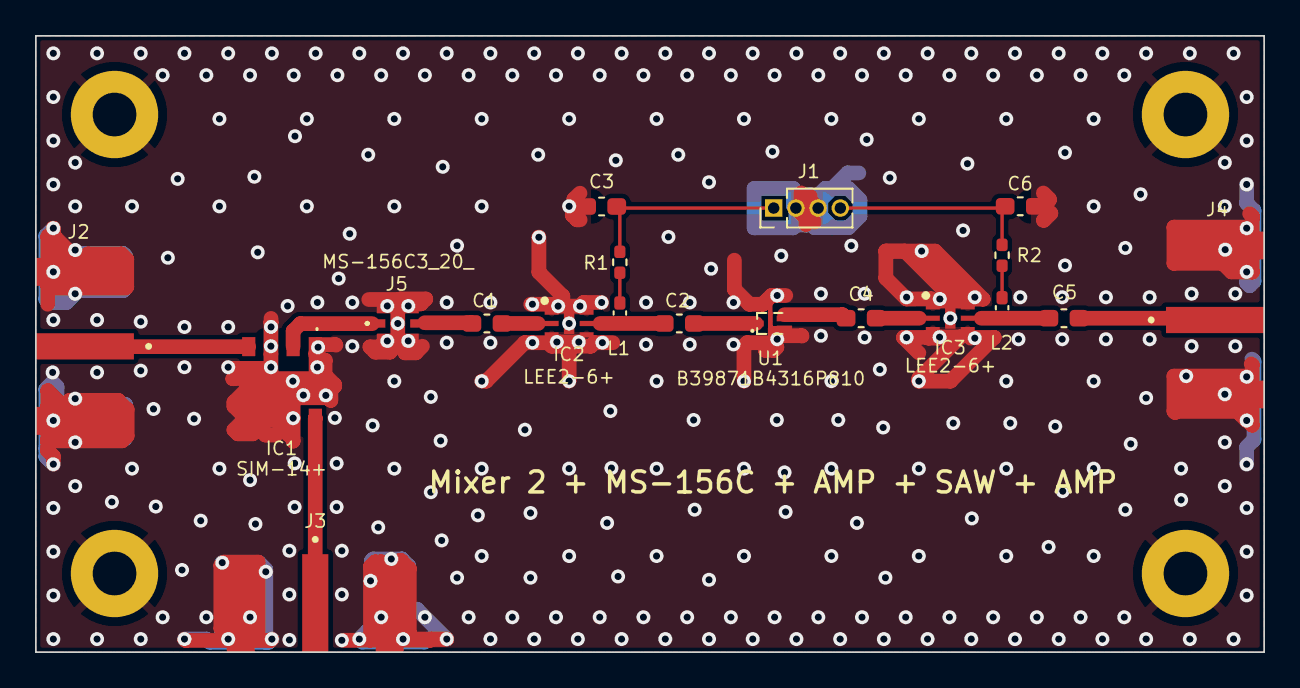
[picture p27: board Mixer_2.kicad_pcb from above]

Board: 2 copper layers, 70.2 x 35.2 mm, 23 parts (0 on the bottom side), 16 nets.

Parts:
C1, C2, C4, C5: 2400 pF; C_0603_1608Metric_Pad1.08x0.95mm_HandSolder
C3, C6: 0.1 uF; C_0603_1608Metric_Pad1.08x0.95mm_HandSolder
H1, H2, H3, H4: M2.5; MountingHole_2.5mm_Pad
IC1: SIM-14+; SIM14
IC2, IC3: LEE2-6+; SON65P200X200X105-7N
J1: Conn_01x04; PinHeader_1x04_P1.27mm_Vertical
J2, J3, J4: SMA; LINX_CONSMA020.062-G
J5: MS-156C3_20_; MS156C320
L1, L2: 120 nH; L_0402_1005Metric_Pad0.77x0.64mm_HandSolder
R1, R2: 88.7; R_0402_1005Metric_Pad0.72x0.64mm_HandSolder
U1: B39871B4316P810

Connections:
/DC1: L1.1, R1.2
/DC2: L2.1, R2.2
/IF: IC1.2 (IF), J5.1 (COMMON)
/LO: IC1.8 (LO), J3.1 (RF)
/MS_out: C1.1, J5.3 (ANTENNA)
/RF: IC1.4 (RF), J2.1 (RF)
/RF_out: C5.2, J4.1 (RF)
/SAW_in: C2.2, U1.1 (IN)
/SAW_out: C4.1, U1.4 (OUT)
/Vdd_amp1: C3.2, J1.1, R1.1
/Vdd_amp2: C6.2, J1.4, R2.1
/amp1_in: C1.2, IC2.2 (RF-IN)
/amp1_out: C2.1, IC2.5 (RF-OUT&_DC-IN), L1.2
/amp2_in: C4.2, IC3.2 (RF-IN)
/amp2_out: C5.1, IC3.5 (RF-OUT&_DC-IN), L2.2
GND: C3.1, C6.1, H1.1, H2.1, H3.1, H4.1, IC1.1 (GROUND_1), IC1.3 (GROUND_2), IC1.5 (GROUND_3), IC1.6 (GROUND_4), IC1.7 (GROUND_5), IC1.9 (GROUND_6), IC1.10 (GROUND_7), IC2.1 (NC_1), IC2.3 (NC_2), IC2.4 (NC_3), IC2.6 (NC_4), IC2.7 (GND), IC3.1 (NC_1), IC3.3 (NC_2), IC3.4 (NC_3), IC3.6 (NC_4), IC3.7 (GND), J1.2, J1.3, J2.S1, J2.S2, J2.S3, J2.S4, J3.S1, J3.S2, J3.S3, J3.S4, J4.S1, J4.S2, J4.S3, J4.S4, J5.2 (GND_1), J5.4 (GND_2), J5.5 (GND_3), J5.6 (GND_4), J5.7 (GND_5), J5.8 (GND_6), U1.2 (GND), U1.3 (GND), U1.5 (GND)
