nanosatlab/RFI-5G/HW/TestBoards/LO1_EvalBoard/LO1_EvalBoard.kicad_pcb

## KiCad design HW/TestBoards/LO1_EvalBoard/LO1_EvalBoard.kicad_pcb (2022-03-31)

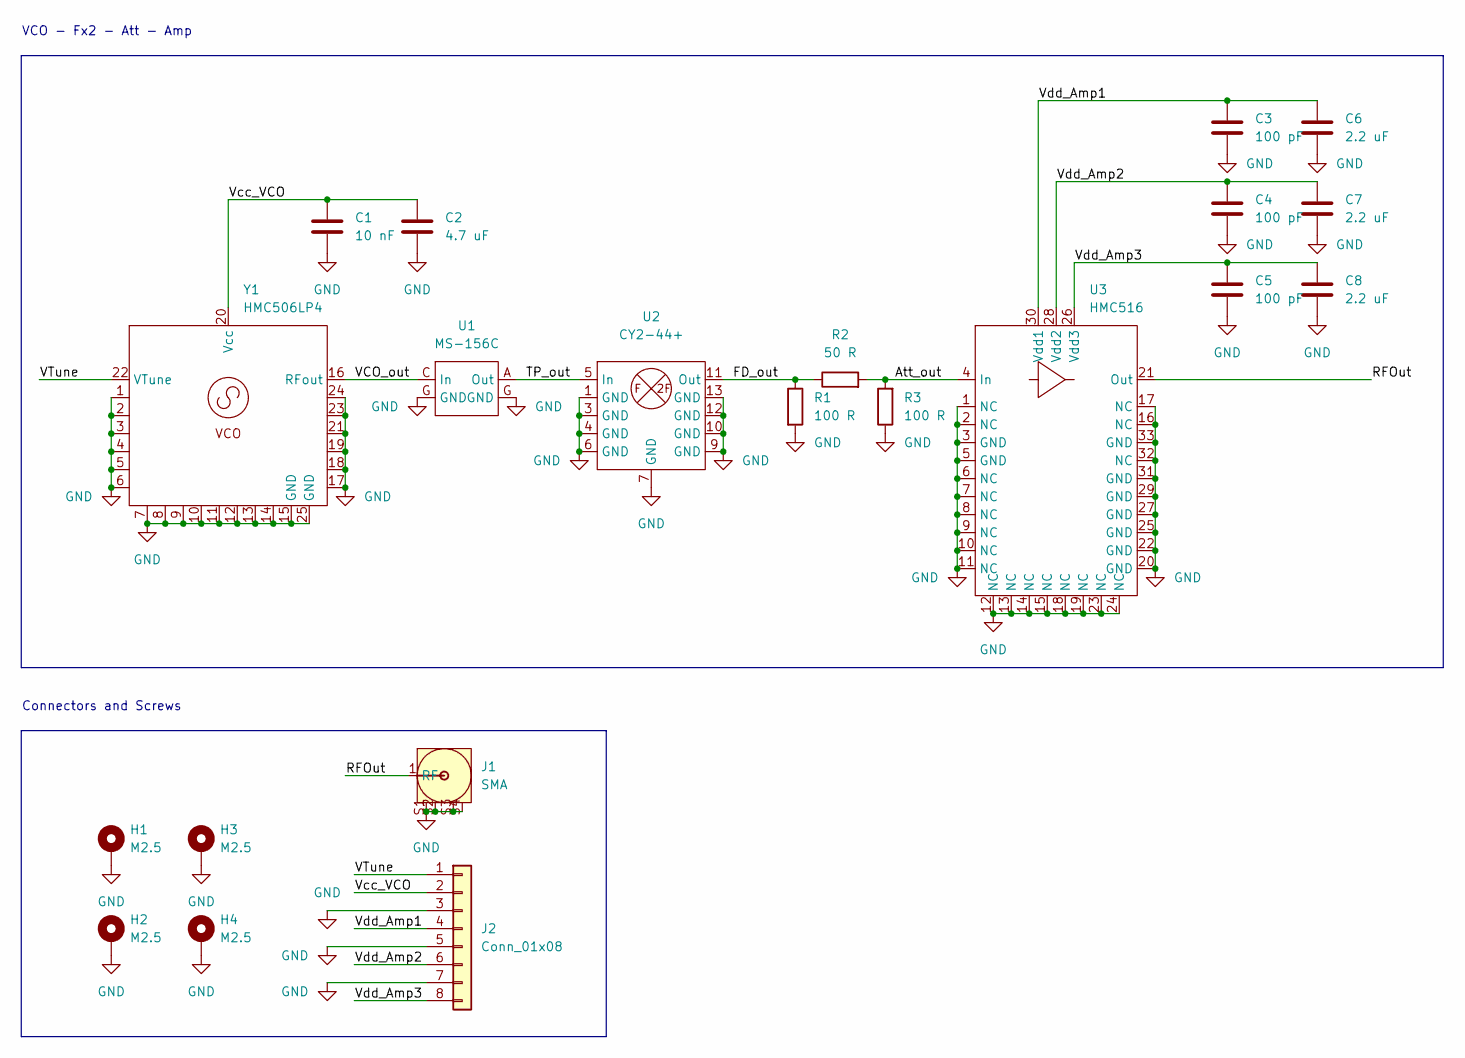
[picture p28: schematic LO1_EvalBoard.kicad_sch]

Parts:
C1: 10 nF; C_0603_1608Metric
C2: 4.7 uF; C_0603_1608Metric
C3, C4, C5: 100 pF; C_0603_1608Metric
C6, C7, C8: 2.2 uF; C_0603_1608Metric
H1, H2, H3, H4: M2.5; MountingHole_2.7mm_M2.5_Pad
J1: SMA; LINX_CONSMA020.062-G
J2: Conn_01x08; PinSocket_1x08_P2.00mm_Vertical
R1, R3: 100 R; R_0603_1608Metric
R2: 50 R; R_0603_1608Metric
U1: MS-156C; CoaxialSwitch_Hirose_MS-156C3_Horizontal
U2: CY2-44+; QFN-12-1EP_3x3mm_P0.5mm_EP1.65x1.65mm
U3: HMC516; QFN-32-1EP_5x5mm_P0.5mm_EP3.6x3.6mm
Y1: HMC506LP4; QFN-24-1EP_4x4mm_P0.5mm_EP2.7x2.7mm

Connections:
/Att_out: R2.2, R3.2, U3.4 (In)
/FD_out: R1.1, R2.1, U2.11 (Out)
/RFOut: J1.1 (RF), U3.21 (Out)
/TP_out: U1.A (Out), U2.5 (In); also elsewhere on the board
/VCO_out: U1.C (In), Y1.16 (RFout); also elsewhere on the board
/VTune: J2.1, Y1.22 (VTune)
/Vcc_VCO: C1.1, C2.1, J2.2, Y1.20 (Vcc)
/Vdd_Amp1: C3.1, C6.1, J2.4, U3.30 (Vdd1)
/Vdd_Amp2: C4.1, C7.1, J2.6, U3.28 (Vdd2)
/Vdd_Amp3: C5.1, C8.1, J2.8, U3.26 (Vdd3)
GND: C1.2, C2.2, C3.2, C4.2, C5.2, C6.2, C7.2, C8.2, H1.1, H2.1, H3.1, H4.1, J1.S1, J1.S2, J1.S3, J1.S4, J2.3, J2.5, J2.7, R1.2, R3.1, U1.G (GND), U2.1 (GND), U2.3 (GND), U2.4 (GND), U2.6 (GND), U2.7 (GND), U2.9 (GND), U2.10 (GND), U2.12 (GND), U2.13 (GND), U3.1 (NC), U3.2 (NC), U3.3 (GND), U3.5 (GND), U3.6 (NC), U3.7 (NC), U3.8 (NC), U3.9 (NC), U3.10 (NC), U3.11 (NC), U3.12 (NC), U3.13 (NC), U3.14 (NC), U3.15 (NC), U3.16 (NC), U3.17 (NC), U3.18 (NC), U3.19 (NC), U3.20 (GND), U3.22 (GND), U3.23 (NC), U3.24 (NC), U3.25 (GND), U3.27 (GND), U3.29 (GND), U3.31 (GND), U3.32 (NC), U3.33 (GND), Y1.1, Y1.2, Y1.3, Y1.4, Y1.5, Y1.6, Y1.7, Y1.8, Y1.9, Y1.10, Y1.11, Y1.12, Y1.13, Y1.14, Y1.15 (GND), Y1.17, Y1.18, Y1.19, Y1.21, Y1.23, Y1.24, Y1.25 (GND); also elsewhere on the board

Notes on the sheet:
Connectors and Screws
VCO - Fx2 - Att - Amp

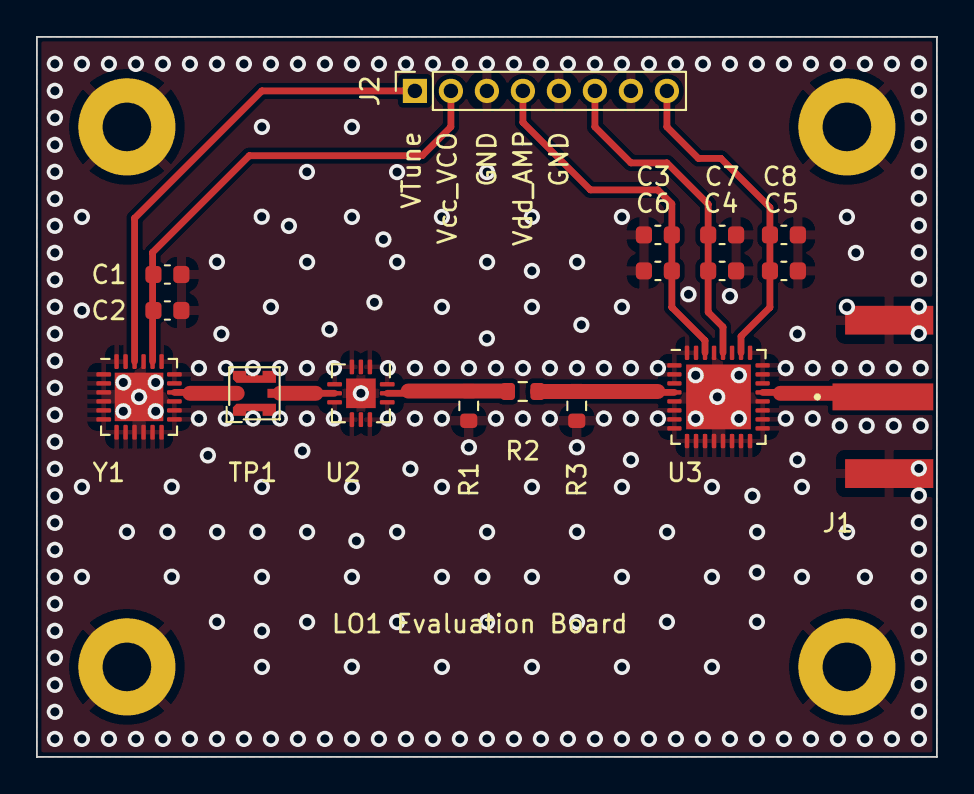
[picture p29: board LO1_EvalBoard.kicad_pcb from above]

Board: 2 copper layers, 50.0 x 40.0 mm, 21 parts (0 on the bottom side), 11 nets.

Other parts of the board:
TP1: MS-156C; CoaxialSwitch_Hirose_MS-156C3_Horizontal

Their connections:
/TP_out: TP1.A (Out); also elsewhere on the board
/VCO_out: TP1.C (In); also elsewhere on the board
GND: TP1.G (GND); also elsewhere on the board
