nanosatlab/RFI-5G/HW/TestBoards/Mixer1_EvalBoard/Mixer_1.kicad_pcb

## KiCad design HW/TestBoards/Mixer1_EvalBoard/Mixer_1.kicad_pcb (2022-03-31)

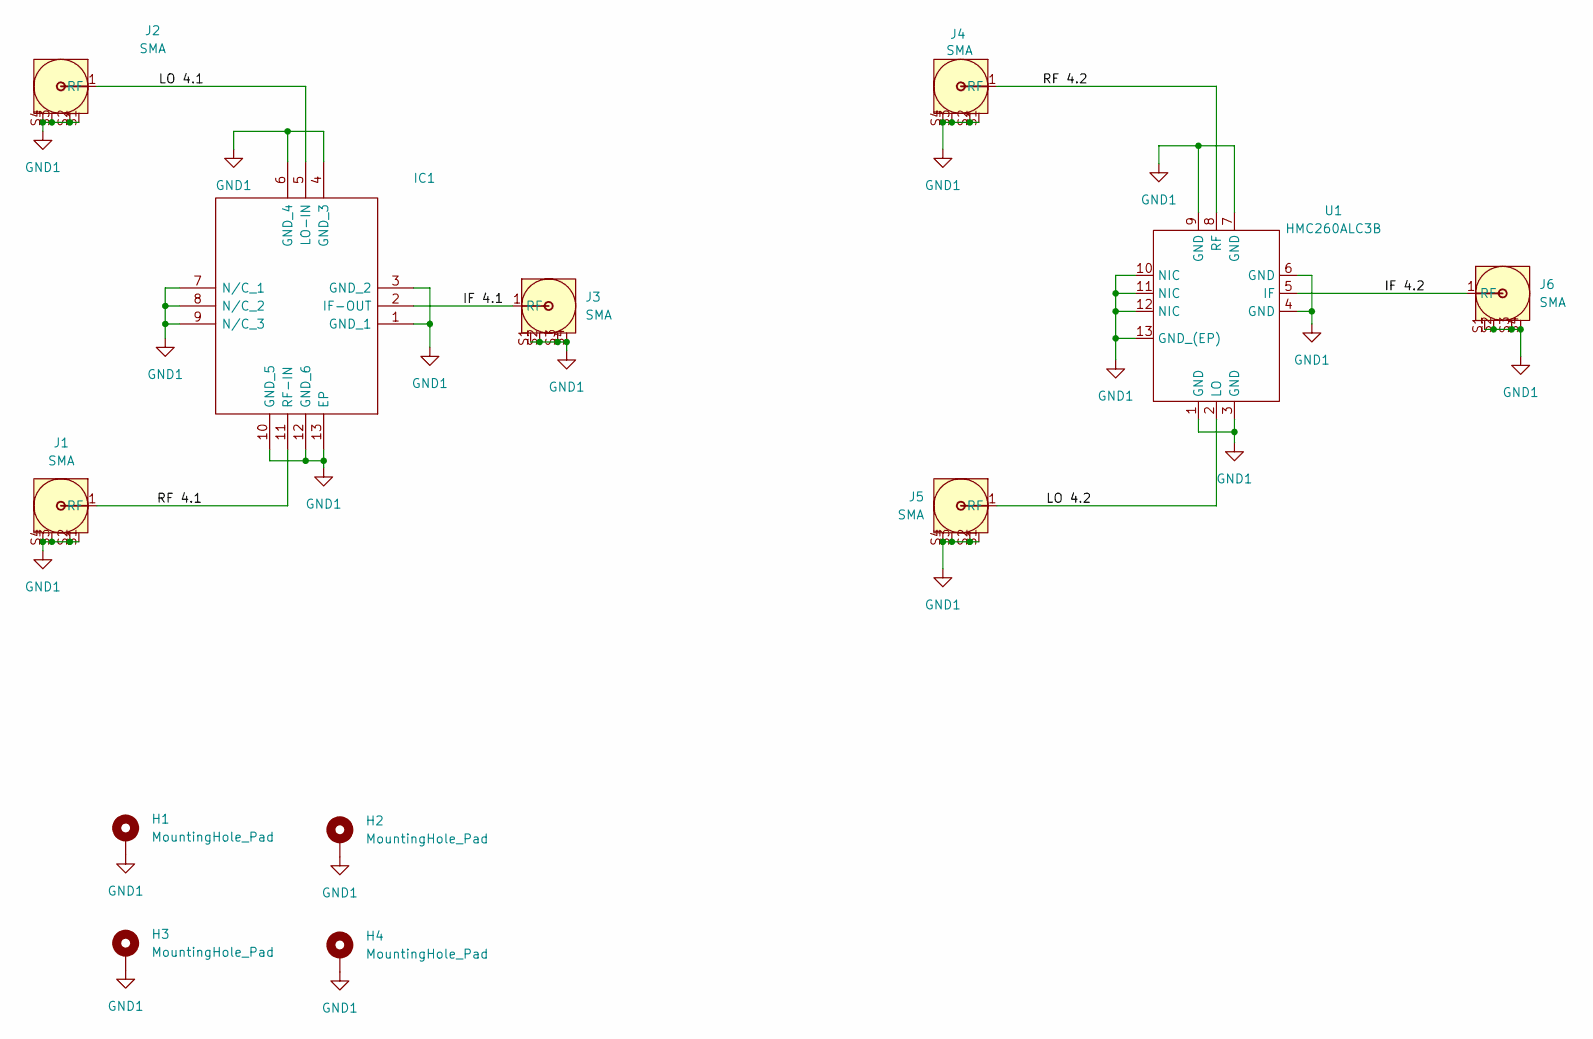
[picture p30: schematic Mixer_1.kicad_sch]

Parts:
H1, H2, H3, H4: MountingHole_Pad; MountingHole_2.5mm_Pad
IC1: QFN51P300X300X89-13N; Mouser Part Number 139-MDB-44H
J1, J2, J3, J4, J5, J6: SMA; LINX_CONSMA020.062-G
U1: HMC260ALC3B

Connections:
/IF 4.1: IC1.2 (IF-OUT), J3.1 (RF)
/IF 4.2: J6.1 (RF), U1.5 (IF)
/LO 4.1: IC1.5 (LO-IN), J2.1 (RF)
/LO 4.2: J5.1 (RF), U1.2 (LO)
/RF 4.1: IC1.11 (RF-IN), J1.1 (RF)
/RF 4.2: J4.1 (RF), U1.8 (RF)
GND1: H1.1, H2.1, H3.1, H4.1, IC1.1 (GND_1), IC1.3 (GND_2), IC1.4 (GND_3), IC1.6 (GND_4), IC1.7 (N/C_1), IC1.8 (N/C_2), IC1.9 (N/C_3), IC1.10 (GND_5), IC1.12 (GND_6), IC1.13 (EP), J1.S1, J1.S2, J1.S3, J1.S4, J2.S1, J2.S2, J2.S3, J2.S4, J3.S1, J3.S2, J3.S3, J3.S4, J4.S1, J4.S2, J4.S3, J4.S4, J5.S1, J5.S2, J5.S3, J5.S4, J6.S1, J6.S2, J6.S3, J6.S4, U1.1 (GND), U1.3 (GND), U1.4 (GND), U1.6 (GND), U1.7 (GND), U1.9 (GND), U1.10 (NIC), U1.11 (NIC), U1.12 (NIC), U1.13 (GND_(EP))

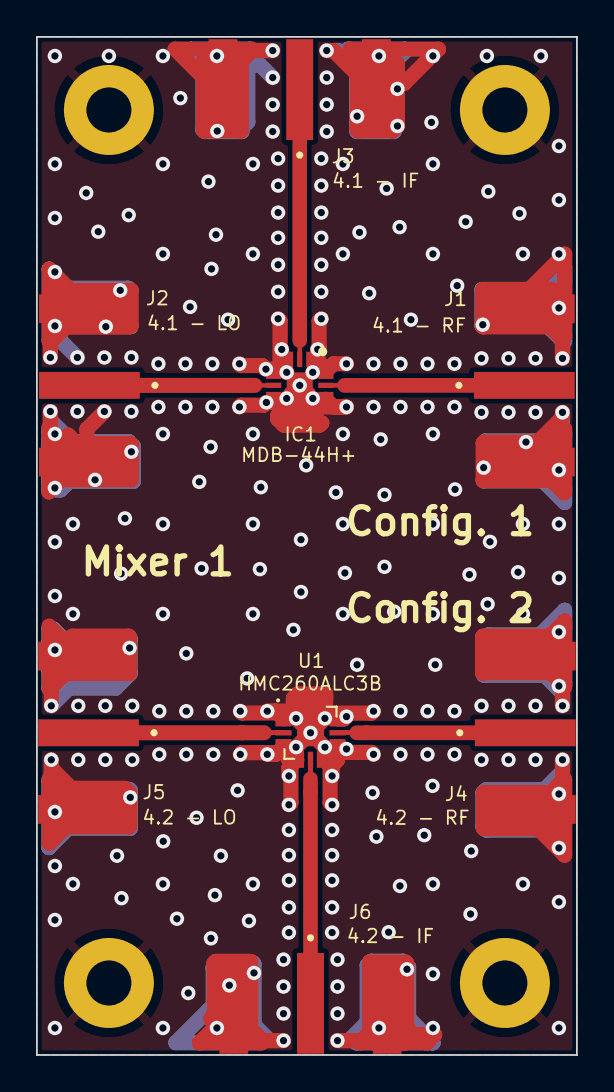
[picture p31: board Mixer_1.kicad_pcb from above]

Board: 2 copper layers, 30.0 x 56.6 mm, 12 parts (0 on the bottom side), 7 nets.
