nanosatlab/RFI-5G/HW/TestBoards/IF1_BPF_EvalBoard/IF1_BPF_EvalBoard_RO4003C_60mils.kicad_pcb

## KiCad design HW/TestBoards/IF1_BPF_EvalBoard/IF1_BPF_EvalBoard_RO4003C_60mils.kicad_pcb (2022-04-12)

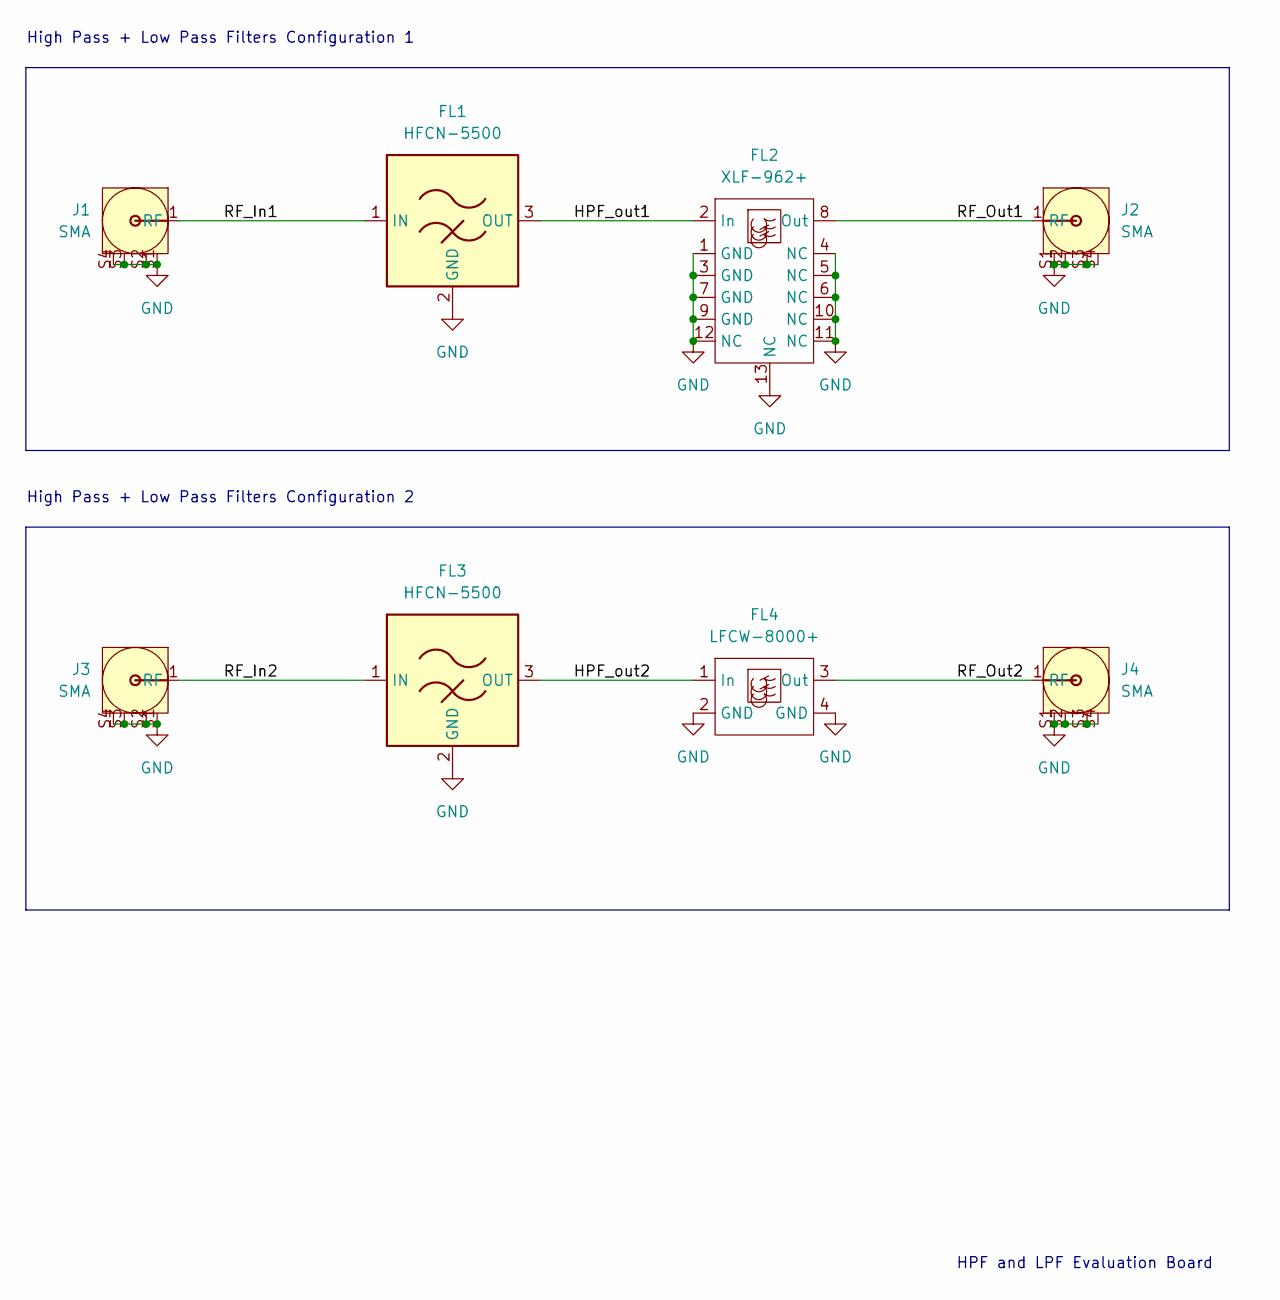
[picture p32: schematic IF1_BPF_EvalBoard.kicad_sch]

Parts:
FL1, FL3: HFCN-5500; Filter_Mini-Circuits_FV1206-1
FL2: XLF-962+; QFN-12-1EP_3x3mm_P0.51mm_EP1.45x1.45mm
FL4: LFCW-8000+; JC0603C-1
J1, J2, J3, J4: SMA; LINX_CONSMA020.062-G

Connections:
/HPF_out1: FL1.3 (OUT), FL2.2 (In)
/HPF_out2: FL3.3 (OUT), FL4.1 (In)
/RF_In1: FL1.1 (IN), J1.1 (RF)
/RF_In2: FL3.1 (IN), J3.1 (RF)
/RF_Out1: FL2.8 (Out), J2.1 (RF)
/RF_Out2: FL4.3 (Out), J4.1 (RF)
GND: FL1.2 (GND), FL1.4 (GND), FL1.5 (GND), FL1.6 (GND), FL2.1 (GND), FL2.3 (GND), FL2.4 (NC), FL2.5 (NC), FL2.6 (NC), FL2.7 (GND), FL2.9 (GND), FL2.10 (NC), FL2.11 (NC), FL2.12 (NC), FL2.13 (NC), FL3.2 (GND), FL3.4 (GND), FL3.5 (GND), FL3.6 (GND), FL4.2 (GND), FL4.4 (GND), J1.S1, J1.S2, J1.S3, J1.S4, J2.S1, J2.S2, J2.S3, J2.S4, J3.S1, J3.S2, J3.S3, J3.S4, J4.S1, J4.S2, J4.S3, J4.S4

Notes on the sheet:
High Pass + Low Pass Filters Configuration 2
HPF and LPF Evaluation Board
High Pass + Low Pass Filters Configuration 1

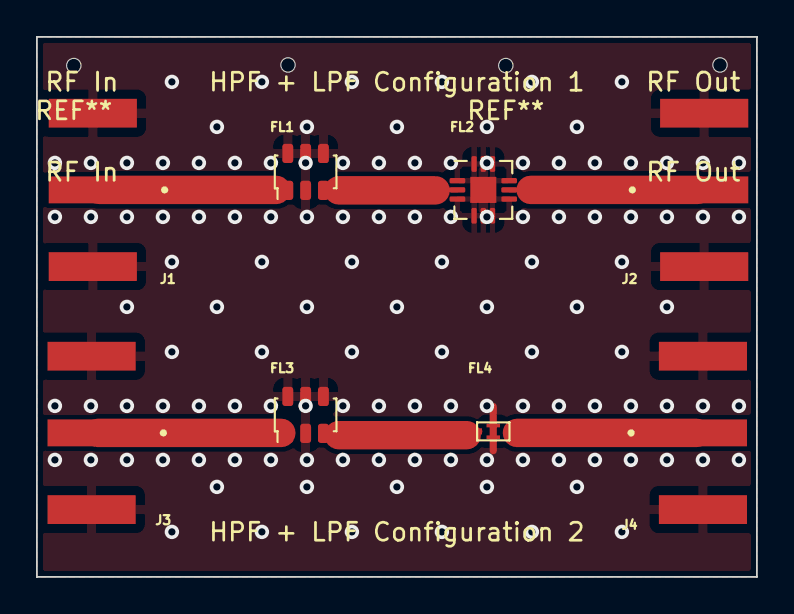
[picture p33: board IF1_BPF_EvalBoard_RO4003C_60mils.kicad_pcb from above]

Board: 2 copper layers, 40.0 x 30.0 mm, 8 parts (0 on the bottom side), 7 nets.
