nanosatlab/RFI-5G/(commit log)

2022-03-21 HPF and LPF EvalBoard
    [IF1_BPF_EvalBoard.kicad_pcb, IF1_BPF_EvalBoard.kicad_sch, RFI-5G.kicad_pcb, RFI-5G.kicad_sch]
2022-03-22 LNA Eval Board
    [LNAs_EvalBoard.kicad_pcb, LNAs_EvalBoard.kicad_sch, LO1_EvalBoard.kicad_pcb, LO1_EvalBoard.kicad_sch]
2022-03-23 LO1 Eval Board
    [IF1_BPF_EvalBoard.kicad_pcb, IF1_BPF_EvalBoard.kicad_sch, LNAs_EvalBoard.kicad_pcb, LNAs_EvalBoard.kicad_sch, LO1_EvalBoard.kicad_pcb, LO1_EvalBoard.kicad_sch]
2022-03-31 All Test Boards developed
    [LNAs_EvalBoard.kicad_pcb, LO1_EvalBoard.kicad_pcb, LO1_EvalBoard.kicad_sch, Mixer_1.kicad_pcb, Mixer_1.kicad_sch, Mixer_2.kicad_pcb, Mixer_2.kicad_sch, VCO_2.kicad_pcb]
2022-04-07 Added Evaluation Boards for RO4003C 1.52 mm
    [IF1_BPF_EvalBoard.kicad_pcb, IF1_BPF_EvalBoard.kicad_sch, IF1_BPF_EvalBoard_RO4003C_60mils.kicad_pcb, IF1_BPF_EvalBoard_RO4350B_20mils.kicad_pcb, LNAs_EvalBoard.kicad_pcb, LNAs_EvalBoard.kicad_sch, LNAs_EvalBoard_Ro4003C_60mils.kicad_pcb, LO1_EvalBoard_RO4003C_60mils.kicad_pcb]
2022-04-12 EvalBoards in RO4003C 60 mils
    [IF1_BPF_EvalBoard_RO4003C_60mils.kicad_pcb]
2022-06-10 Boards started
    [Boost1.kicad_sch, Boost2.kicad_sch, Connectors.kicad_sch, Inst_amps.kicad_sch, LDOs.kicad_sch, RFI-5G.kicad_pcb, RFI-5G.kicad_sch, RFI-5G_RF_Bottom.kicad_pcb]
2022-06-15 RF top and Bottom boards
    [Boost1.kicad_sch, Boost2.kicad_sch, Connectors.kicad_sch, Inst_amps.kicad_sch, LDOs.kicad_sch, RFI-5G_RF_Bottom&Top.kicad_pcb, RFI-5G_RF_Bottom&Top.kicad_sch, RFI-5G_RF_Bottom.kicad_pcb]
2022-06-21 PL boards
    [Connectors.kicad_sch, RFI-5G_RF_Bottom.kicad_pcb, RFI-5G_RF_Bottom.kicad_sch, RFI-5G_RF_Top.kicad_pcb, RFI-5G_RF_Top.kicad_sch, Support_Top.STEP, low_freq_board.kicad_pcb, low_freq_board.kicad_sch]
2022-07-15 All boards dseigned, thickness change pending
    [Connectors.kicad_sch, PCB_Outline_2022-03-01.step, RFI-5G_RF_Bottom-User_1.dxf, RFI-5G_RF_Bottom.kicad_pcb, RFI-5G_RF_Bottom.kicad_sch, RFI-5G_RF_Top-B_Mask.dxf, RFI-5G_RF_Top-Edge_Cuts.dxf, RFI-5G_RF_Top-User_Eco1.dxf]
2022-08-02 almost finished PCB's
    [RFI-5G_RF_Bottom.kicad_pcb, RFI-5G_RF_Top.kicad_pcb, RFI-5G_RF_Top.kicad_sch, RFI-5G_SupportFR4.kicad_pcb, RFI-5G_SupportFR4.kicad_sch, RFI-5G_SupportFR4.step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]
